oangelo/esp32-gate-intercom/cad/README.md

# CAD

Parametric OpenSCAD for the gate intercom enclosure. Two printed parts plus the hardware that goes
through their walls:

- **base** - the back tray: **closed on the wall face**, which is the one face that carries nothing
  because it beds flat on the post, and opened through its **bottom**, where the two microphone slots
  are cut (ADR-023). It carries the three pads that push the unit forward onto the seat, the two M3
  carriers (ADR-031: gussets grown off the side walls, their insert holes bored into their flat tops),
  the **unit cradles at each end** (ADR-028, ADR-029), the gland's boss and the pad its locknut bears
  on, and — through its own back
  plate — the two M4 pockets and holes that ARE the fixing (ADR-021, ADR-027: no ears on the sides).
- **lid** - the front shell: the **closed grille** over the unit's own grille, the spot-faced seat the
  unit's disc presses on, and the **Ø25.00 flat land** and **Ø22.10 cutout** for the panel button — the
  switch's own 22.00 plus 0.10 of clearance (ADR-018, ADR-033) -- and, since ADR-034, a shell whose convex
  edges are all rolled by 2.00 mm, the front's rim included.

## Files

| File | What it is |
|---|---|
| `case.scad` | The whole enclosure. One file, parameters at the top, `part` selects what to export |
| `media/` | Scratch for renders, written by the `make` targets and git-ignored (empty in a fresh clone) |

Status of `case.scad`: **revision 3, steps 1 and 2 done, re-cut around the assembled unit.** Roadmap
item 5 was decided the other way on 2026-09-24: the Waveshare goes in whole, as it arrives, so the lid
no longer builds its own speaker chamber — its front stays **closed** over the unit's grille and just
drills the sound holes (a O44 recessed field of O2 holes, the unit's own grille right behind them).
Those same holes are the speaker's air path out, and the microphones have their own way in: **two thin
slots, 1.20 × 8.00 mm, through the BOTTOM of the base** close behind the unit, one each side at the
microphones' own x, each under a hydrophobic membrane stuck straight on the bottom's curve (ADR-023,
which moved them off the back plate — that face beds flat against the post — and dropped the Ø9 spot
face that was meant as the membrane's land). Keeping the two apart is the point — the microphones used
to share the speaker's field, which is direct coupling.
The base keeps three pads that push the unit onto a spot-faced seat in the lid. Case depth went from 49
to 58.70 — 58 when the unit went in, 58.4 when the shell grew to 3.4 mm, and the last 0.30 from the
caliper's height — and the unit sits low (centre at 33.4) to free the upper half for the button at 76.4.
`make fit` proves the unit clears both printed parts, that the two parts clear each other across the lap
(`fitcheck_pair`), and — through the probes (`probe_grille`, `probe_button`, `probe_mic`, `probe_gland`,
`probe_m4`, `probe_vent`) — that the openings are open through the walls, by boolean instead of by eye.
`fitcheck_cap` closes the loop on ADR-035's plug: it asks that the cap finds its bore and that its crowned top
never stands on the crown it was cut from.

The lid-to-base joint is cut as of review 3: two M3 x 12 socket head screws (ISO 4762, stainless A2,
into brass inserts per ADR-017) pull the lid down onto two carriers that grow off the cavity's side
walls (ADR-031 — they stood on pillars off the back plate until 2026-10-04), in
the corridor between the unit and the panel switch. Each screw's counterbore is cut from the crown's
own surface at the screw's x, and the lid's boss under it (`m3_lid_boss`) is what the head clamps --
the wall alone is 3.01 mm there and the counterbore is 4.40 (ADR-035: the head sinks **1.40 below the
crown**), so the wall on its own would leave the head with nothing to pull against -- and the boss is what
leaves it the 1.61 it clamps. The 1.40 the head gives up is a **printed cap** (`part="cap"`, Ø5.50, its top cut
by the crown's own cylinder so it closes the hole flush, its bottom stopping on the head). `fitcheck_joint` answers the whole thing by boolean, and
`-D 'fc=...'` narrows the answer when it is not empty -- `screw`, `neighbours`, `cradles` or
`carriers`. `probe_carrier` asks the one question none of those can: that the carriers' material is
where it has to be, by cutting its rods out of the base (they must not exist outside it).

The joint itself is a **half-lap** as of this review (ADR-024): the lid carries a lip and the base the
recess it drops into, all the way round the contour, so the two halves can no longer be shifted sideways
against each other and no longer meet on a bare flat plane. The lip is the outer 1.50 mm of the lid's
3.40 mm shell, reached 3.00 mm back past the plane and **flush** with the case's surface; the recess takes
the outer 1.70 mm of the base's wall over the same 3.00 mm and leaves a 1.70 mm rim, so the two are
**0.20 mm apart** all round. Nothing protrudes any more: the first cut stood the lip 0.40 mm proud as a
**drip shadow**, the user's call was that the ridge reads badly ("fica feio"), and the case grew 0.8 mm
across instead -- its own surface is what a film of water runs down, and the mouth of the 0.20 mm gap is
the first line against it, ahead of the 3.00 mm of lap and the shoulder where the foam ring sits.
`fitcheck_pair` proves the lap by boolean -- the two parts against each other, minus one `eps` either side
of the joint plane, which is a contact and not an interference.
Neither part pays for the lap with support: through its last 3 mm the base's wall goes 3.40 to 1.70 mm and
the lid's 3.40 to 1.50, so both shapes only lose material as the print rises.

The unit is located at **both ends** now, by the four arcs of ADR-028 and ADR-029, and that is where the case's
own width shows: the cavity is Ø60 inside and the unit calipers at Ø57.5, so there is **1.25 mm** of daylight
to spend. The arcs spend 1.00 mm of it on each side and leave 0.25 mm of clearance to the cover at each end.
`-D 'fc="cradles"'` isolates that check. ADR-020's closed collar, which used to hold the back end, is **out**:
its bore was 0.20 mm a side and a 360° ring has nothing to give, so the printed base would not take the unit
at all.

Each band is two arcs of ±35° about the ±X directions, inner surface at r = 29.00. The **front** band runs from
y = 11.05 to 25.55, with a 40° print ramp lifting the clearance past y = 16.05 (ADR-028); the **back** band is
that same profile **translated** to the other end of the unit — hug from y = 48.30 to 53.30, its ramp climbing
away from the mouth and landing on the cavity's floor at y = 55.30, so the first layer the printer lays of it
rests on the plate (ADR-029). Together they are what stops the unit sliding, rattling, and dropping out of the
base when the lid comes off. `fitcheck` proves the clearance, and the arcs are why it stays empty: the surface
that faces the cover is the band's own keep-out cylinder, 0.05 mm inside the sector's chord.

The two wall screws sit on the centre line at the quarter points of the height, z = 24.2 and z = 72.6
(ADR-021), so the pair is symmetric about the case's own centre and the hanging weight arrives at them as
shear. In X they were already on x = 0; only Z moved, from 7/59.

Everything that view draws is switchable, without editing the file: OpenSCAD's **Customizer** panel
(the `show_*` block at the top of `case.scad`) gives a tick box each for the lid, the base, the unit,
the screws, the unit cradles and the M4, plus `show_solid` for the shell drawn opaque instead of as a
background object. All of them default to on, so an untouched file opens exactly as it always did.
Note that the shells are background (`%`) objects and `--render` does not draw those, which is why the
markers show up in the PNGs: in a PNG the shell appears only under `show_solid`.

The print set is **four** parts: base, lid, gasket and, since ADR-035, the two **caps** that close the
counterbores over the screw heads (`part="cap"`, `make cap`, Ø5.50, printed flat, flush when pressed in) --
`make stl` exports all of them.

Still to come: nothing. The feature list is complete as of 2026-09-26. The joint's gasket
is drawn as its own part — `part="gasket"` or `make gasket`: 1.70 mm wide, 1.00 mm of TPU 95A printed soft
and squeezed to 0.70, flat on the shoulder the lap leaves, proved by `fitcheck_gasket` (ADR-024's "The ring
itself"). The vent is a Ø4.20 hole in the middle of the -X side — mid-height, where the capsule's straight
band makes the wall a flat plane and the hole square to it, so the 3.40 mm of wall is crossed cleanly — a
horizontal tunnel with a 4.2 mm bridge for a ceiling, proved by `probe_vent`. It was Ø4.00 with a breathable
membrane **stuck over it** (ADR-026); since ADR-033 it takes a **screwed M5x0.8 e-PTFE breather valve** off the
shelf, and 4.20 is that thread's tapping drill, so the hole is the pilot the valve forms its thread in over
3.05 mm of wall (3.8 turns — the number still to be checked against the part). The mouth still carries the
**Ø11.00 × 0.35 recess** it was given for the patch — 0.50 of clearance around a Ø10.00 patch, and the wall
under the floor goes from 3.40 to 3.05 — and whether that recess becomes the valve's O-ring seat is one of the
open questions, not a decided one. A counterbore in a vertical wall adds no overhang to the print. The two microphone membranes are
drawn too, as patches on the bottom's own curve — `show_mic_mem` — and nothing is cut for them, which is
ADR-023's answer to "the membranes' seats". The gland's top is cut (ADR-025):
a Ø22 x 3.00 boss with a 50 degree tail, a Ø12.50 hole that is a teardrop over its whole length -- its roof
meeting the flat on a 45 degree ramp, which leaves the gasket's washer its 1.20 mm of land without leaving
the print anything to bridge -- and a pad under the locknut. The gland sat on the unit's own axis (29.85 mm
back) so that the pigtail left it and dropped straight into the unit's USB-C, which points up at the unit's
top edge; the user moved it back along +Y twice, 10.59 mm on 2026-09-29 to 40.44 mm (ADR-030), and 3.90 more
on 2026-10-04 to **44.34 mm** (ADR-032), where the boss's tail's point lands exactly on the case's back face
-- the bed -- so the boss's first layer is printed on the plate instead of 3.90 mm above it, and in z from 127.20
to 130.00 the tail merges into the plate as a buttress. The port is still under the hole, so the drop is a
flight of about 22 degrees rather than the plumb line it was, and that is what the two moves cost; the bed's
own plane is the limit now, because further back the point would poke through the plate. For the hole itself
neither move changes anything, which the audit shows rather than asserts. `probe_gland` is what proves that opening is one hole. The two mounting ears were drawn and then dropped, by
the user, the same day: what fixes the case is the two M4 through the back plate, so nothing is added to the
sides and the case stays 66.80 mm wide (ADR-027). The two wall screws are cut, since ADR-021
had them decided: a Ø8.00 x 1.50 pocket in the plate's inner face for the head and a Ø4.50 hole on through
the 3.40 of plate, which leaves 1.90 of it, proved by `probe_m4`.

## Rules for this design

1. **No hardcoded dimensions.** Every number lives in the parameter block at the top, with a comment
   pointing at its source in `docs/dimensions.md`. If a measurement changes, one variable changes.
2. **ASA, not ABS and not PETG.** Outdoors, in the sun, on a gate post (ADR-009).
3. **Wall 3 mm minimum**, 3 perimeters at 0.4 mm. Nothing thinner than 1.2 mm anywhere except a gasket
   groove.
4. **No support material.** No overhang beyond 45 degrees and no bridge longer than 10 mm.
5. **Both parts print lying down**, with the case's depth as the printer's Z: the base on its back plate
   and the lid on its face. That is what makes the lid's grille holes print as vertical holes instead of
   a 44 mm ceiling to bridge, and it depends on the flat lands that step 2 spot-faces into the front
   face.
6. **Clearances are for FDM and for ASA shrinkage**: 0.2 mm for a tight fit, 0.3 mm for sliding,
   0.5 mm for loose. Heat-set inserts instead of printed threads. The board takes M2.5 inserts (its own
   mounting holes are 4.00 mm); the case joint and the ears take M3 and M4.

## Print settings that work for ASA

| Setting | Value |
|---|---|
| Nozzle temperature | 250 to 260 °C |
| Bed temperature | 100 to 110 °C |
| Chamber | enclosed, warm (passively heated by the bed is enough) |
| Part cooling | off, or a very low fan after layer 3 |
| First layer | brim, 10 mm, for warp control |
| Layer height | 0.2 mm |
| Perimeters | 3 |
| Infill | 25 percent, gyroid |

## Commands

    make check     # compile the model and surface any warning or error
    make stl       # export build/case_base.stl and build/case_lid.stl
    make render    # PNG preview into cad/media/ (starts its own Xvfb display)
    make review    # the review view at three angles: screws, carriers, inserts, cradles
    make section   # cutaway render, the review view: the assembled unit inside
    make inside_render  # translucent shell: the unit inside, and the rejected bare-parts layout
    make exploded  # the two printed parts pulled apart
    make fit       # prove the ghosts touch no wall and the openings are open; must be empty twelve times

`make check` must be clean before any export is taken seriously: OpenSCAD happily writes an STL with a
non-manifold object, and a sliced mesh with gaps is a failed print, not a cosmetic problem.

**Renders that show the inside of a shell must pass `--render`, and the shell must be a `%` object.**
Measured on this model: a white shell with `color(..., 0.15)` produced zero pixels of the internal
colours in the PNG, in preview and with `--render`, while the `%` (background) modifier with `--render`
kept all of them. `make inside_render` does both and prints the md5 of the two images, because two
views that must differ and come out byte-identical mean the render path ate the difference, not that
the selector is wrong.

## Validation, not eyeballing

`make fit` answers the interference question with a boolean, not with a picture: it intersects the wall
(the body minus the cavity) with each ghost volume, and an empty result means the part clears every wall.
A non-empty result comes with the ghost's name, and `-D 'fitwhich="speaker"'` narrows it to one part. That
is how the first real error in this file was found: the flat face of the speaker met the curved inner face
of the front, 0.2 mm of interference at the rim, invisible in a render.

Still to come in F2: `tools/check_case.py`, which loads the exported meshes with trimesh and asserts that
each is watertight and a single component, that the board volume fits inside the cavity with the intended
clearance, that no wall intersects the board, the speaker or the battery bay, and that the measured wall
thickness matches the parameter.
