oangelo/esp32-gate-intercom/cad/case.scad

// ESP32 Gate Intercom - enclosure, revision 2
// Parametric case for a Waveshare ESP32-S3-AUDIO-Board. Printed in ASA (ADR-009).
//
// STATUS: revision 2 - the form, the fit and the openings are cut. This file has the capsule profile,
// the crown on the front face, the cavity, the joint at y = 8 with its half-lap (the lid's lip in the
// base's recess), the closed grille field over the unit, the button's lands and its cutout, the two
// microphone slots through the bottom, the two M3 x 12 that close the case, and the unit, speaker and
// buck as ghosts to prove they fit. Still to come, in this order, each one reviewed before the next:
//   1. the gasket itself: the ring is drawn now -- printed in TPU 95A, soft -- and it lies flat on the
//      1.70 mm shoulder the lap leaves. No groove -- at that width a groove would leave 0.35 mm of wall
//      -- and the two screws squeeze the ring from 1.00 to 0.70, which is what the joint closes by
//      (ADR-024 and its 2026-09-26 amendment, ADR-017)
//   2. the list is complete as of 2026-09-26. The cable gland's top went in with ADR-025, the vent is cut
//      in the middle of the -X side with ADR-026, and the microphone membranes need NO seat (they are drawn
//      as patches on the bottom's curve -- ADR-023). The unit is cradled by two bands of arcs on the
//      +/-X sides, one at each end of it (ADR-028, ADR-029): the collar that used to hold its back end
//      is GONE, because on the printed base it was too tight to take the unit at all. There are NO
//      mounting ears: what holds the case is the two M4 through its back plate, which was already cut
//      with ADR-021 (ADR-027 records the reversal)
// Every number below is measured or derived; the source of each is docs/dimensions.md.
//
// Frame: X = width, Y = depth (0 at the apex of the front face, CASE_D at the back plate),
// Z = height (0 at the floor). The case stands upright in use.
//
// PRINT ORIENTATION: both parts print lying down, with the case's Y as the printer's Z.
// The base prints on its back plate (cavity opening up, insert holes vertical, microphone slots
// vertical)
// and the lid prints on its face (cavity opening up, so the grille's 49 holes come out as
// vertical holes instead of a 44 mm ceiling to bridge, and the lands that step 2 spot-faces into the
// crown give it its bed contact). The lap costs neither part a support, and with the lip flush there is
// no sideways step in either part: through its last 3 mm the base's wall goes from 3.40 to 1.70 mm and
// the lid's from 3.40 to 1.50, so both shapes only lose material as the print rises.
//
// One feature has its axis IN the bed, and it is the one that costs: the cable gland goes through the
// TOP, along the case's Z, which is the printer's Y. A boss and a hole lying in the bed plane would need
// support on one side (the print rises along -Y, so everything facing +Y hangs), so the boss carries a
// 45 degree tail on its back side and the hole a teardrop inside -- the same shapes the microphone slots
// get, for the same reason. Rule 4's one concession in the whole case is named where it is made, with
// the gland's parameters.
//
// Usage:
//   openscad -D 'part="base"'         -o build/case_base.stl  cad/case.scad
//   openscad -D 'part="lid"'          -o build/case_lid.stl   cad/case.scad
//   openscad -D 'part="assembly"'     -o cad/media/form.png   cad/case.scad   # opaque, outer form
//   openscad -D 'part="inside"'       -o cad/media/in.png     cad/case.scad   # translucent shell
//   openscad -D 'part="inside_parts"' ...                                     # rejected layout
//   openscad -D 'part="section"'      ...                                     # cutaway, review
//   openscad -D 'part="exploded"'     ...                                     # the two parts apart
//   openscad -D 'part="cradles"'      -o build/cradles.stl cad/case.scad       # the four arcs alone, to measure
//   openscad -D 'part="fitcheck"'     ...                                     # must be EMPTY
//   openscad -D 'part="fitcheck_pair"' ...                                    # must be EMPTY
//   openscad -D 'part="probe_grille"' ...                                     # must be EMPTY
//   openscad -D 'part="probe_button"' ...                                     # must be EMPTY
//   openscad -D 'part="probe_mic"'    ...                                     # must be EMPTY
//   openscad -D 'part="probe_gland"'  ...                                     # must be EMPTY
//   openscad -D 'part="probe_m4"'     ...                                     # must be EMPTY
//   openscad -D 'part="probe_vent"'   ...                                     # must be EMPTY
//   openscad -D 'part="fitcheck_gasket"' ...                                   # must be EMPTY
//   openscad -D 'part="gasket"'       -o build/gasket.stl ...                 # the ring on its own, to print in TPU
//
// Everything is selected through `part`, one selector for every view. The translucent views need
// --render: without it the PNG export draws the shell as opaque and the internals disappear, which
// makes two views that must differ come out byte-identical. Compare with md5 and with
// --summary all, never by looking at the picture.
//
// Convention: millimetres. Variable names are ASCII only (the parser breaks on accents).

// ------------------------------------------------------ the Z stretch (ADR-034)
// The user needs room UNDER the unit: its 2x9 header is the end that points down, and the case gave it
// 1.25 mm. So the unit rises by `lift` and the whole upper assembly rises with it -- the button and its
// two lands, the joint screws and their carriers, the gland, the cavity's ceiling -- which is what keeps
// every clearance the case was checked for exactly as it was (the switch's body stays 0.25 mm off the
// unit's top edge, the land keeps 4.50 of wall above it, the M3 pair stays in the corridor). The only
// new space is below the unit, and that is the point. The capsule pays for it in its straight band.
lift     = 6.00;        // how far the unit rises, and with it everything above it. 6.00 is the user's
                        // "uns milimetros" with a DuPont connector in mind; it is the ONE number to change
// ---------------------------------------------------------------------------------------------------
// THE KNOBS (2026-10-25: "tem um parametro para eu controlar a altura?"). They are independent, they are
// annotated for the CUSTOMIZER (View > Customizer gives each of them a slider or a step), and `make fit`
// is what guards them: a value that pushes a ghost into a wall fails the check instead of printing.
//   case_h -- the height, apex to apex. FLOOR 99.80: the button's land needs 4.50 of wall above it and
//            the cavity's ceiling sits 3.40 below the apex (btn_cz + 12.50 + 4.50 + 3.40). No ceiling,
//            only the print bed (lying on its back the case needs case_h x 66.80 of plate).
//   btn_cz -- the button's centre, from the bottom. FLOOR 79.40: the switch's body (O22, 30 deep) hangs
//            11.00 below the button's centre and has to clear the unit's top edge (68.15) by 0.25. That
//            is what decides how central the button can look: 164.80 was the height that put it at
//            exactly half, and it read too long; at 130.00 the middle is 65.00 and 79.40 is as near as
//            the hardware goes (the button ends up 14.40 above the middle, and 47.20 below the ceiling)
//   m3b_dz -- the two joint screws, this far BELOW the button (they ride with it, so the pair always
//            stays in the corridor between the unit and the switch). 9.40 is the proven number: the
//            carrier's gusset (3.50 either side of the screw) then tops out at 73.50, 0.52 mm under the
//            switch's ghost, which is what fitcheck_joint's `neighbours` bites on -- 8.80 put it 0.08 mm
//            INTO it (btn 79.40, screws 70.60, gusset top 74.10, ghost floor 74.02). At 9.40 the pair
//            straddles the middle of a 150.00 case: 74.70 against 75.00.
/* [The knobs] */
// height of the case, apex to apex. Floor 99.80, no ceiling but the print bed
case_h   = 130.00;      // [100:2:220]
// the button's centre, from the bottom. Floor 79.40 (the switch's body against the unit)
btn_cz   = 79.40;       // [79.4:0.2:160]
// how far below the button the two joint screws sit. 9.40 is the floor for this button height
m3b_dz   = 9.40;        // [8.6:0.2:16]
// NOT moved by the lift, and they have to be checked against it: the microphone slots (cut in the
// bottom, so they stay where the bottom is -- the air path from them to the unit's own ports grows by
// `lift`, which is why 6.00 was preferred to 10) and the two M4, which are the quarter points of the
// height and therefore drift with it (37.50 and 112.50 at case_h = 150.00) -- still symmetric about it.

// --------------------------------------------------------- measured (docs/dimensions.md)
board_dia    = 57.63;   // board is ROUND. The vendor DXF says 58.00, and the unit's own body calipers
                        // at 57.50 (2026-09-26), so the board sits a shade under both. Unused by any
                        // solid: the assembled unit is what goes in now
board_t      = 1.20;    // PCB thickness, vendor STEP (it is not 1.6)
board_hole_d = 4.00;    // three mounting holes, with a 4.80 ring (the vendor's M2.5 studs)
board_hole_r = 23.75;   // radius of the hole pattern from the board centre
board_hole_a = [36.1, -36.1, 180.0];   // hole angles, board frame, +Y pointing down in the case
comp_h_top   = 5.00;    // tallest part on the component side: the 2x9 header
comp_h_bot   = 4.50;    // tallest part on the solder side: the speaker header
mic_port_r   = 26.83;   // microphone acoustic port, from the board centre, component side
mic_port_a   = [47.2, 132.8];
spk_od       = 43.30;   // SPK-4020-5W, no screw holes of its own (used by the bare-parts ghosts,
spk_d        = 20.50;   // which document the hollowing-out option that was rejected)

// --------------------------------------------------------- case parameters
part    = "review";     // the one selector: review | inside | assembly | inside_parts | base | lid |
                        // gasket | section | exploded | cradles | screwplan | fitcheck | fitcheck_parts |
                        // fitcheck_internal | fitcheck_joint | fitcheck_pair | fitcheck_gasket |
                        // probe_grille | probe_button | probe_mic | probe_gland | probe_m4 |
                        // probe_vent
                        // Default is `review`: the shell and the unit as ghosts, the planned screws whole.
                        // `assembly` is the same thing opaque, for the outer form.

// ------------------------------------------------------- what the review view draws
// The switches below belong to the `review` view (and its alias `screwplan2`) -- `part` chooses WHICH
// view, these choose WHAT it draws. They are annotated for the CUSTOMIZER: OpenSCAD's Customizer panel
// (or View > Customizer) shows them as tick boxes, and F5 redraws as you tick. An untouched file draws
// everything, exactly as before.
//
// Why they exist: the review view is the joint seen through the shell, and six solids at once is a lot
// to read. Un-tick what is in the way -- the unit to look at the carrier against the switch, the screws
// to look at the holes they will sit in, both shells to look at the marker set alone.
//
// One trap, measured: the shell is a % (background) object and `--render` does not draw those at all --
// that is exactly why the markers come out visible in the PNGs. So un-ticking the shells changes F5 (the
// preview you work in) and changes nothing in a `make review` PNG; in a PNG the shell only appears with
// `show_solid`, which draws it as an ordinary opaque object instead.
/* [The review view] */
show_lid      = true;   // [true,false]  the front shell, with its grille and the button
show_base     = true;   // [true,false]  the back tray, with the bosses and the carriers
show_solid    = false;  // [true,false]  the shell solid and opaque, instead of a % (background) object
show_unit     = true;   // [true,false]  the assembled Waveshare, as a ghost
show_screws   = true;   // [true,false]  the two M3, their carriers and the brass inserts
show_cradles  = true;   // [true,false]  the arcs that cradle the unit, at both ends of it (cut material,
                        //                drawn green so it reads under the shell)
show_m4       = true;   // [true,false]  the two M4 into the wall, as markers: the pockets and holes they
                        //                sit in are cut in the base (m4_pockets())
show_gland    = true;   // [true,false]  the PG7 gland on the top's boss, with its cable (a marker: the
                        //                hole and the boss are cut into the base, the gland is not)
show_gasket   = true;   // [true,false]  the joint's gasket ring -- printed in TPU -- on the shoulder the
                        //                lap leaves (a separate part: neither half carries it)
show_vent     = true;   // [true,false]  the breathable membrane over the vent hole (a marker: the hole
                        //                through the side wall is cut, the membrane is stuck on)
show_mic_mem  = true;   // [true,false]  the two hydrophobic membranes over the microphone slots (also
                        //                markers: nothing is cut for them, ADR-023)

// DECIDED (2026-09-24): the Waveshare goes in ASSEMBLED, as one cylinder -- board, black body with
// the speaker inside, acrylic band and cover, all screwed together, and its own acoustic chamber and
// microphone ducting come with it. The case is built around that, which is what the depth above and
// the unit placement below are.
//
// The case is closed except for two kinds of opening, both deliberate: the front is solid over the unit
// with a recessed grille field drilled through it (the sound leaves through ours and then through the
// unit's), and the BOTTOM carries the two microphone ports, low and close behind the unit. Neither of
// the other two faces will do for the microphones: the front field is the speaker's own air path (the
// direct coupling ADR-014 exists to prevent) and the wall face is bedded flat on the gate post, so a
// port there breathes mortar, not air. The bottom is what is left, and it is what ADR-014 asked for all
// along ("on the back and low side, facing down where the geometry allows"). The two slots open into
// the 1.80 mm gap behind the unit, which is the volume the microphones breathe.
//
// Height, and why the model uses 47.30: CALIPER, 2026-09-26, on the real part, and the caliper is
// what decides wherever the vendor files disagree (docs/dimensions.md): the whole unit with its
// three rubber feet measures 50.00, the feet are 2.70 stuck on the grille face, and with the unit's
// grille face forward those feet would press against the front wall -- so they come off and the unit
// is 47.30. Diameter, same caliper: 57.50, half a millimetre under the O58 the vendor files claim.
// The vendor sources, for the record: the STEP measures 49.70 assembled (so it reads 0.30 short),
// the product page says 43.70 + 5.10 = 48.80, the DXF says 44.30 to the bottom of the body and
// 47.00 to the bottom of the O52 disc, and 37.60 is PCB top to body bottom. Everything below
// derives from the two calipered numbers, and the whole interior follows them.
unit_dia  = 57.50;
unit_h    = 47.30;      // 50.00 calipered with the feet on, minus their 2.70
unit_face_y = 6.20;     // its grille face: clears the inner crown at the unit's rim by 1.00 mm
unit_cy   = unit_face_y + unit_h / 2;   // 29.85: unit centre on the depth axis
unit_cz   = 33.40 + lift;   // z_btm (33.40) + the lift: was the LOWEST it could sit and still clear the
                        // rounded bottom, and rising is what frees the room below for the 2x9 header's
                        // connectors (ADR-034). Was 33.00 at a 3.0 mm wall: the skin grew 0.4 and the whole
                        // interior came with it, so the 1.25 mm gap around the unit is untouched

case_w  = 66.8;         // the cavity's O60 plus 2 x 3.4 of wall. Was 66.0 at a 3.0 wall: the case grew
                        // 0.8 across so the joint's lip could sit flush with its surface (ADR-024),
                        // which leaves the board 1.19 mm of clearance a side instead of 1.00
straight = case_h - case_w;    // 83.20: the capsule's straight side, z_btm to z_top, from the height above
                        // (it was 30.00 at 96.80, and 98.00 at the 164.80 that read too long)
case_d  = 58.7;         // the unit's depth 47.30 (feet peeled off) + the front gap at its face (6.20)
                        // + the back gap (1.80) + the plate (3.40) = 58.70, so it follows unit_h one
                        // for one. Was 58.0, then 58.4 when the shell grew to 3.4. DECIDED: the
                        // assembled unit goes in whole. Was 49 when the plan was a bare board and our
                        // own chamber
wall    = 3.4;          // was 3.0. The extra 0.4 a side is what lets the lap's lip sit FLUSH with the
                        // case's own surface instead of standing 0.40 proud as a ridge on the outside
                        // (the user's call: "fica feio"). It also takes the base's rim at the lap from
                        // 1.30 to 1.70 mm. The cavity does not move: still O60, 1.25 mm around the
                        // O57.5 unit (ADR-020)
wall_front = 3.0;       // the FRONT wall stays 3.0, so the crown's inner surface, the grille field's
                        // depth and the unit's seat keep the geometry they were designed with. At 3.4
                        // the inner crown would recede to 6.50 at the unit's rim and the seat's own
                        // plane (6.25) would end up inside the wall -- which is exactly how the
                        // fitcheck caught this: 1.30 mm3 of the unit's ghost buried in the lid
r_end   = case_w / 2;   // 33.4: radius of both ends
z_btm   = r_end;                       // 33.4: centre of the bottom semicircle
z_top   = case_h - r_end;              // 63.4: centre of the top semicircle
crown_s = 5.0;                         // sagitta of the front crown (convex front, ADR-015)
crown_r = (pow(r_end, 2) + pow(crown_s, 2)) / (2 * crown_s);   // 114.06

// The joint is `joint_y` (8.0), defined with the lap further down, because that is where its three
// numbers come from. It used to be 27.5 here, as `split_y`: a flat contact, and neither the lip nor
// the screws of review 3 would work there.
inner_d = case_d - wall;               // 55.30: inner face of the back plate
cav_x   = r_end - wall;                // 30: inner radius; the ends share the outside centres
cav_y0  = wall_front;                  // 3.0: inner apex of the crown, at the front wall's thickness
crown_in = crown_r - wall_front;       // 111.06: its radius, so the front wall is 3.0 and not the shell's

// The three board standoffs (r = 23.75 at -36.1, +36.1, 180 degrees) leave exactly three gaps
// against the wall: around 0 degrees (+X side), 108 degrees (upper left) and 252 degrees (lower
// left). Every joint boss, and every feature that has to reach the back plate, lives in one of those three
// gaps, because the board's 57.63 fills the rest of the back plate. Nothing else fits behind it.
//
// With the bottom end round, the cavity narrows fast below z = 33.4 (at z = 8 it is only +-16.0),
// so the board also has to sit high enough that its 57.63 clears the curve: at its centre height
// of 37.4 mm the clearance is 1 mm a side, and it is the sides, not the floor, that decide.

// The inner face of the front is the crown, so it recedes as it goes out: at the speaker's
// radius (21.65) it sits at y = 5.54 instead of 3.40. A flat speaker face has to clear that,
// which is why it starts at 5.65 and why step 1 spot-faces a flat seat into the crown.
spk_cy   = 15.90;       // speaker front face at 5.65, then half its depth (bare-parts ghost)
board_cy = 30.60;       // board front face at 30.00: 4 mm behind the speaker (bare-parts ghost)
board_cz = 37.40;       // board centre height (bare-parts ghost)
spk_cz   = 26.40;       // speaker centre height (bare-parts ghost)

eps = 0.01;
$fa = 2;
$fs = 0.4;

// --------------------------------------------------------- features: grille (lid, lower half)
// The unit brings its own grille behind the disc face, and the case's front is CLOSED over it: a
// recessed field of through holes, so the sound leaves through ours and then through the unit's. The
// microphones no longer share this field: they have their own two ports through the back plate (the
// microphone block further down), which is what stops the speaker from firing straight into them.
grille_od    = 44.0;    // the field, inside the unit's own O46 grille area
grille_rec   = 0.80;    // recess behind the crown's apex: makes the drip lip and a flat print face
grille_hole  = 2.0;     // hole diameter
grille_pitch = 4.5;     // hole pitch; the grid is clipped to a circle of 4 cells
grille_tilt  = 15.0;    // holes tilted so their outer end is lower and water runs out
// The unit is held axially by two things: this flat seat in the lid (the disc's face presses on it)
// and the pads on the back plate pushing it forward. With the front closed over the unit, nothing can
// come forward any more, so the seat's only job is to be flat and to stop the speaker leaking sideways.
unit_seat_d   = 53.0;   // seat diameter: the disc's O52 plus a shoulder
unit_pad_d    = 8.0;
unit_pad_r    = 23.0;   // clear of the vendor's O1 holes (r <= 8.9) and of the O57.5 edge
unit_pad_h    = 1.75;   // the gap behind the unit is 1.80: 0.05 mm of relief so the fit check still
                        // proves the unit clears. In the build a 1 mm foam pad goes here, which also
                        // seals the disc against the seat: that seal is what keeps the speaker out of
                        // the cavity the microphones breathe.

// --------------------------------------------------- the unit's cradles (base, at both ends of it)
// ADR-028 / ADR-029. The pads above hold the unit axially, but nothing touches its sides: the cavity is
// a O60 bore and the unit is a O57.50 body, so 1.25 mm of daylight rings it and it can slide, rattle
// and -- with the lid off -- drop out. Two BANDS of arcs do the locating, one at each end of the unit:
// 35 degrees either side of the +/-X directions, hugging at a quarter of a millimetre. The ring that
// used to hold the back end (the collar, ADR-020) is OUT: its bore was O57.90 against the unit's
// O57.50 -- 0.20 mm a side, a closed 360 degree ring with nothing to give -- and the printed part was
// too tight to take the unit at all (2026-09-28, the user's call). They are arcs and not a full ring
// either (also the user's call): the top and bottom of the bore are left alone.
cradle_a      = 35.0;   // half the arc, measured about the +/-X directions on the unit's axis
cradle_hug    = 5.00;   // the band that hugs at the design clearance, at each end of the unit
cradle_slope  = 0.84;   // rise per mm of depth: 40 degrees, inside the 45 the print rules allow. The cone
                        // that cuts it runs 0.50 mm past each band's end (that overshoot is what keeps
                        // the subtraction off the material's own face), so the slope it ACTUALLY cuts
                        // is 0.798 per mm -- 38.6 degrees. Measured on the mesh (part = "cradles"):
                        // 29.359 at y = 16.50 and 29.758 at 17.00, 0.40 per half millimetre
cradle_clr    = 0.50;   // radial clearance to the unit's cover. Was 0.25, the collar's 0.20 one step up,
                        // and the print proved it too tight at the mouth: the unit has to find the bore
                        // with its rim at an angle, and 0.25 all round is a 0.50 hole on a 57.50 cover
                        // that goes in by hand. 0.50 is A' of the three options put to the user on
                        // 2026-10-24 (A' takes 390.10 mm3 out of the base); it is the widest that
                        // still holds -- 1.00 mm of total play, and each band keeps its full 5.00 mm of
                        // bore at the unit's end (cradle_hug)
cradle_lead   = 1.20;   // the lead-in bevel at each band's mouth (45 deg) -- the front band's faces
                        // the unit's rim, the back band's faces its back end, so what the unit finds is
                        // a mouth and not a step. Was 0.40: with 0.50 of clearance a 0.40 bevel barely
                        // shows, and this is the bevel that does the guiding
cradle_r_in   = unit_dia / 2 + cradle_clr;                  // 29.25: the hugging surface
cradle_r_out  = cradle_r_in + 15;                           // 44: a bound only, body() clips it
cradle_ramp_r = cradle_r_in + 9.5 * cradle_slope;           // 36.98: wider than the bore's own radius
                        // anywhere in the arc (30 / cos 35 = 36.62), which is what makes a ramp fade to
                        // nothing instead of ending on the ledge a printer would have to bridge
// The FRONT band (ADR-028), the one the print proved: its face at the mouth, its ramp leaning away from
// the mouth as the depth grows, and a bevel at that face.
cradle_y0     = 11.05;  // the mouth-side face. NOT nearer the mouth: the joint's band runs to
                        // y = 11.01 (the base's recess, cut over joint_y +/- eps), and a cradle that
                        // reached into it left the recess cut with coincident faces to work on and the
                        // boolean came back with the ring still in place. 0.04 clear of it, and still
                        // the front quarter of a 50.70 deep base.
cradle_y_full = cradle_y0 + cradle_hug;                     // 16.05: where the ramp takes over
cradle_y_end  = cradle_y_full + 9.5;                        // 25.55: past this the front band adds
                        // nothing
// The BACK band (ADR-029), the collar's replacement: the front band's own profile, TRANSLATED to the
// other end of the unit -- not mirrored, and the difference is the print's. The base prints bedded on
// its back plate, so the deep end of the case is the FIRST layer printed (ADR-028 has this the right way
// round: "the cradle's deep end is printed first"). A band whose hug sat at its deep end would begin life
// as a ledge hanging over the void -- 1.00 mm of it at the +/-X directions, and over 6.00 mm at the arc's
// edges, where the cavity's wall is further from the unit's axis -- which is exactly what ADR-028's ramp
// exists to avoid. A first cut here was that mirror (2026-09-28) and the review caught it on sight.
// Translated, the ramp climbs away from the mouth into the deep end and the band lands on the cavity's
// floor, so its own deepest layer is the plate's surface: nothing hangs, and the unit's back end still
// finds a lead-in bevel exactly like the front band's.
rear_y0       = 48.30;  // its mouth-side face, and the first thing the unit's back end meets: 5.20 mm
                        // short of the unit's own back face (53.50), so the 5.00 mm of hug behind it
                        // sits on the unit's last 5 mm -- the skirt the collar gave (3.20) and more
rear_y_full   = rear_y0 + cradle_hug;               // 53.30: where the hug ends and the ramp starts
rear_y_end    = inner_d;                            // 55.30: the cavity's floor. The ramp runs into it
                        // and is cut off there -- 2.00 mm of rise, r = 29.25 to 30.85 at the +/-X
                        // directions, where it fades out entirely at 54.55 -- so the band's deepest
                        // material is the plate's own face. It is also 17 mm clear of the vent's mouth
                        // on the -X side (y = 29.35 +/- 2.00), which `probe_vent` keeps honest anyway

// --------------------------------------------------------- features: button (lid, upper half)
// A bought 22 mm panel switch (ADR-018) seals against a FLAT land, and the front face is convex:
// so the cutout gets a spot-faced land outside (for the switch gasket) and another inside (for the
// nut), which also keeps the wall between them a uniform 3.3 mm.
btn_sw      = 22.0;     // the switch's own cutout (ADR-018): O22 through its thread
btn_clr     = 0.10;     // clearance in the cutout, the user's call (2026-10-24): 0.05 a side. Under rule
                        // 6's 0.2 tight fit, on purpose -- the switch's own gasket is what seals the
                        // hole, so the plastic only has to let the body through without scraping
btn_cut     = btn_sw + btn_clr;   // 22.10: what the lid is actually cut with. The lands below are NOT
                        // keyed to it: they are set by the switch's gasket and nut, so widening the
                        // hole moves neither, and the land's annulus around the hole widens with it
btn_land    = 25.0;     // outer land diameter: the switch gasket's seat, and now the flange's (ABA)
                        // 2026-10-24, the user's call: 25.00, so the flange drops into a pocket whose
                        // FLOOR is flat at y = btn_land_y. Was 29.00, chosen to be flat "gasket and
                        // enough" and not 31 for the ceiling -- with 25 that margin only grows. What
                        // the 4 mm cost: the annulus left around the 22.10 hole goes 3.50 -> 1.45 mm,
                        // still over rule 3's 1.20. Depth of the pocket at its rim (r = 12.50) is
                        // 0.51 mm, not 1.20: the crown is at y = 0.687 there, so that is how far the
                        // floor sits under the surface at the edge. The floor itself is FLAT, which
                        // is what a flange sits on; only the edge depth varies
btn_land_in = 30.0;     // 76 the inner land tops out at 91 and the cavity's ceiling is at 93, so the
                        // wall above the hole keeps 2 mm of material instead of reaching zero
btn_land_y  = 1.20;     // outer land plane: 1.20 mm into the crown at its apex. A round-over at the
                        // pocket's mouth was tried twice on 2026-10-25 and both were rejected: a torus
                        // tangent to the SEAT cut the face at an angle, and the arc tangent to BOTH
                        // needed the pocket 0.50 deeper (1.70) to have room -- and the user still read
                        // it as a step in the wrong place. Dropped: the mouth keeps its 90 degree edge,
                        // and this stays where ADR-033 left it
btn_land_in_y = 4.50;   // inner land plane: uniform 3.3 mm of wall between the two
// btn_cz is a KNOB, set with case_h at the top of the file; see the block there for its floor and why.

// ------------------------------------------------------------------- helpers

module prism_xz(depth, y0 = 0) {
    // Extrude a 2D shape drawn in (x = width, y = height) along the case's Y (depth).
    translate([0, y0 + depth, 0]) rotate([90, 0, 0]) linear_extrude(height = depth) children();
}

module prism_xy(h, z0 = 0) {
    // Extrude a 2D shape drawn in (x = width, y = depth) along the case's Z (height). The gland's boss
    // is this kind of prism: its own axis is the case's Z, so its cross-section is the case's XY.
    translate([0, 0, z0]) linear_extrude(height = h) children();
}

module outline_outer() {
    // A capsule: semicircle at each end, two straight sides, 30 mm of straight between them.
    union() {
        translate([-r_end, z_btm]) square([case_w, z_top - z_btm]);
        translate([0, z_btm]) circle(r = r_end);
        translate([0, z_top]) circle(r = r_end);
    }
}

module outline_inner() {
    // Same shape, offset inwards by the wall: radius r_end - wall = cav_x (30), same end centres.
    outline_offset(wall);
}

module outline_offset(d) {
    // The capsule offset INWARDS by d -- d negative grows it OUTWARDS -- the ends' radius reduced by
    // d with the same end centres. outline_inner() is this at d = wall. The lap uses it twice: at
    // lap_step, for the lip's inner edge, and at -lap_proud, for the lip's outer surface.
    union() {
        translate([d - r_end, z_btm]) square([2 * (r_end - d), z_top - z_btm]);
        translate([0, z_btm]) circle(r = r_end - d);
        translate([0, z_top]) circle(r = r_end - d);
    }
}

// The capsule's own OUTER surface at a given z: r_end out on the straight band (the flat sides), and the
// end circle's radius where an end curves away -- which end by which half of the case the z falls in.
function face_x(z) = (z > z_btm && z < z_top) ? r_end : sqrt(pow(r_end, 2) - pow(z - (z > z_top ? z_top : z_btm), 2));

// The same for the INNER surface (the cavity's wall), cav_x out on the straight band. It exists because
// a carrier's gusset is tall enough to span both regions: before ADR-034 the M3 pair sat above z_top, in
// the top end's circle, and the wall was a sqrt of a positive number; with the case grown, the pair is
// deep inside the straight band, where the old expression took the sqrt of a negative and the gusset came
// out as nan (it cost fitcheck_pair, fitcheck_joint and probe_carrier to catch it).
function cav_face_x(z) = (z > z_btm && z < z_top) ? cav_x : sqrt(pow(cav_x, 2) - pow(z - (z > z_top ? z_top : z_btm), 2));

module crown_outer() { translate([0, crown_r, -1]) cylinder(r = crown_r, h = case_h + 2); }
module crown_inner() { translate([0, crown_r, -1]) cylinder(r = crown_in, h = case_h + 2); }

// ADR-034, option B: the shell is now the OPENING of the two prisms by a ball of radius front_bezel_r --
// erode both prisms by r, dilate by the same ball. Morphologically that rounds EVERY convex edge of the
// shell by exactly r and leaves every flat face exactly where it was, and it does not care which two
// surfaces meet at the crease. That is why it is the only construction that also takes the crease over
// the two DOMES (73 degrees opening to 90 at each apex): a section-based fillet cannot, and three of them
// were built and rejected -- see docs/decisions.md. Set front_bezel_r = 0 to get the old sharp shell.
front_bezel_r = 2.00;
bezel_fn     = 24;      // facets around the dilating ball. The ball has to REACH the original surface, and
                        // a polyhedral ball falls short of its own radius between vertices: at $fn = 10 the
                        // front's apex came out at y = 0.098 instead of 0.00, i.e. exactly r(1 - cos 18).
                        // 24 puts that error at 0.017 mm and costs nothing: the whole base still renders in
                        // 0.2 s, because the core is one convex intersection and Manifold does it fast

module arete_prisms(r) {
    // the two prisms eroded by r: the capsule's outline in by r, the crown's cylinder smaller by r
    intersection() {
        // the prism is also SHORTENED by r at each end: the offset works on the 2D outline only, so
        // without this the prism would still run 0..case_d and the dilating ball would push the case
        // 1.90 mm deeper at the back (measured: the base came out at 60.602 and +14 070 mm3)
        prism_xz(case_d - 2 * r, r) outline_offset(r);
        translate([0, crown_r, -1]) cylinder(r = crown_r - r, h = case_h + 2);
    }
}

module body() {
    if (front_bezel_r <= 0) {
        intersection() {
            prism_xz(case_d) outline_outer();
            crown_outer();
        }
    } else {
        minkowski() {
            arete_prisms(front_bezel_r);
            sphere(r = front_bezel_r, $fn = bezel_fn);
        }
    }
}

module cavity() {
    intersection() {
        prism_xz(inner_d - cav_y0, cav_y0) outline_inner();
        crown_inner();
    }
}

module keep_above(y0) { translate([-500, y0, -500]) cube([1000, 1000, 1000]); }
module keep_below(y0) { translate([-500, y0 - 1000, -500]) cube([1000, 1000, 1000]); }

module sector_xz(r_in, r_out, a0, a1, cz, y0, h, n = 24) {
    // A wedge of an annulus, drawn in the (x, z) plane around (0, cz) and extruded along Y.
    prism_xz(h, y0) translate([0, cz]) polygon(concat(
        [[r_in * cos(a0), r_in * sin(a0)]],
        [for (i = [0:n]) [r_out * cos(a0 + (a1 - a0) * i / n), r_out * sin(a0 + (a1 - a0) * i / n)]],
        [[r_in * cos(a1), r_in * sin(a1)]]));
}

// ------------------------------------------------- the unit's seat and the grille (lid)

module unit_seat_cut() {
    // Spot-faces the inner face of the front flat, so the unit's grille disc has a plane to sit on.
    // 0.05 mm behind the ghost's face: without it the two surfaces are coplanar and the boolean
    // intersection grows slivers instead of reporting a clean empty.
    translate([0, unit_face_y + 0.05, unit_cz]) rotate([-90, 0, 0])
        cylinder(d = unit_seat_d, h = 20);
}

module grille_hole_cut(d) {
    // Same axes for the cut and for the probe, only the diameter changes: 5x5 cells clipped to a
    // circle, tilted so the outer end is lower than the inner one (ADR-018: water runs out). 10 mm
    // of length, because in front of the seat the wall is up to 6.2 mm thick.
    for (ix = [-4:4], iz = [-4:4])
        if (ix * ix + iz * iz <= 16)
            translate([ix * grille_pitch, -1, unit_cz + iz * grille_pitch])
                rotate([-(90 - grille_tilt), 0, 0]) cylinder(d = d, h = 10);
}

module grille_cut() {
    // The field is a spot-face: it gives the drip lip around it and, when the lid prints lying on its
    // face, a flat area instead of one line of contact.
    translate([0, grille_rec - 25, unit_cz]) rotate([-90, 0, 0]) cylinder(d = grille_od, h = 25);
    grille_hole_cut(grille_hole);
}

module unit_pads() {
    // Three pads, 120 degrees apart, pushing the unit's cover forward onto the seat. They are the only
    // thing holding it now: the front is closed over the unit, so it can no longer come out forward.
    for (a = [0:120:240])
        translate([unit_pad_r * cos(a), inner_d - unit_pad_h, unit_cz + unit_pad_r * sin(a)])
            rotate([-90, 0, 0]) cylinder(d = unit_pad_d, h = unit_pad_h + eps);
}

module unit_cradle_y_slab(y0, y1) {
    // A band's own depth band, and the only place any of it is allowed to live: without this the
    // subtraction below would eat into the base's front wall on its way to the bore.
    prism_xz(y1 - y0, y0) square([200, 200], center = true);
}

module unit_cradle_keepout_slab(y0, y1) {
    // The keep-out's own band: 0.05 proud of the cradle's at both ends. The two bands must NOT be
    // coplanar -- exactly coincident faces are how CGAL hands back a zero-thickness sheet instead of a
    // clean subtraction, and here that showed up as the arc's own corners surviving at r = 28.5.
    prism_xz(y1 - y0 + 0.1, y0 - 0.05) square([200, 200], center = true);
}

module unit_cradle_keepout_front() {
    // What the front cradle must NOT occupy: the unit's cover plus `cradle_clr`, and then the print
    // ramp, which is the same surface lifting away as the depth grows. Subtracting it from the case's
    // own solid means the cradle cannot poke out of the shell, and the ramp costs no extra geometry:
    // the steepest face it leaves is `cradle_slope`, 40 degrees, under the 45 the rules allow.
    intersection() {
        union() {
            // the lead-in: 0.40 wider over its own length, so the bevel is 45 degrees at the mouth
            translate([0, cradle_y0 - 1, unit_cz]) rotate([-90, 0, 0])
                cylinder(r = cradle_r_in + cradle_lead, h = 1 + cradle_lead + eps, $fn = 128);
            // the hug itself: the unit's cover plus the clearance, flat along the arc
            translate([0, cradle_y0 + cradle_lead, unit_cz]) rotate([-90, 0, 0])
                cylinder(r = cradle_r_in, h = cradle_hug - cradle_lead + eps, $fn = 128);
            // the ramp: same axis, from the clearance out to `cradle_ramp_r` at the deep end
            translate([0, cradle_y_full, unit_cz]) rotate([-90, 0, 0])
                cylinder(r1 = cradle_r_in, r2 = cradle_ramp_r,
                         h = cradle_y_end - cradle_y_full + 0.5, $fn = 128);
        }
        unit_cradle_keepout_slab(cradle_y0, cradle_y_end);
    }
}

module unit_cradle_keepout_rear() {
    // The back band's keep-out: the front one's three pieces, translated to the other end of the unit.
    // Everything that faces the unit is built the same way -- the lead-in bevel at the mouth, the hug at
    // the clearance, the ramp behind them -- and only the depth band moves, which is what leaves the
    // band's lowest layer sitting on the cavity's floor instead of hanging over the void.
    intersection() {
        union() {
            // the lead-in: 0.40 wider over its own length, so the bevel is 45 degrees at the mouth
            translate([0, rear_y0 - 1, unit_cz]) rotate([-90, 0, 0])
                cylinder(r = cradle_r_in + cradle_lead, h = 1 + cradle_lead + eps, $fn = 128);
            // the hug itself: the unit's cover plus the clearance, flat along the arc. It runs 0.50 past
            // `rear_y_full`, where the ramp takes over, so the two pieces never meet on a coplanar face
            translate([0, rear_y0 + cradle_lead, unit_cz]) rotate([-90, 0, 0])
                cylinder(r = cradle_r_in, h = cradle_hug - cradle_lead + 0.5, $fn = 128);
            // the ramp: same axis, from the clearance out to `cradle_ramp_r`, running past the floor.
            // The band's own slab cuts it off at the floor, so what the print sees is 2.00 mm of rise
            translate([0, rear_y_full, unit_cz]) rotate([-90, 0, 0])
                cylinder(r1 = cradle_r_in, r2 = cradle_ramp_r,
                         h = 9.5 + 0.5, $fn = 128);
        }
        unit_cradle_keepout_slab(rear_y0, rear_y_end + eps);
    }
}

module unit_cradle_band(y0, y1) {
    // One side of one band. Three clips in a row: the case's own solid (so nothing can stand proud of
    // the shell), minus the unit's room and the band's own ramp -- that is `children(0)`, the band's
    // keep-out -- then the arc, then the depth band. The arc's inner radius sits 0.05 clear of the
    // keep-out, so the surface that actually faces the unit is the keep-out's own cylinder and not the
    // wedge's chord.
    intersection() {
        difference() {
            body();
            children(0);
        }
        sector_xz(cradle_r_in + 0.05, cradle_r_out, -cradle_a, cradle_a, unit_cz, -10, case_d + 20, 32);
        unit_cradle_y_slab(y0, y1);
    }
}

module unit_cradles() {
    // Four arcs: both sides, at both ends of the unit. The pair about X is a mirror, the back pair is the
    // front pair TRANSLATED along the depth (not mirrored: see the band's parameters -- the print decides
    // which way round it goes), and together they are the only thing that touches the unit sideways:
    // `fitcheck` proves the 0.25 mm of clearance round the whole cover, and `fitcheck_joint` with
    // `fc = "cradles"` bites the four arcs on their own.
    unit_cradle_band(cradle_y0, cradle_y_end) unit_cradle_keepout_front();
    mirror([1, 0, 0]) unit_cradle_band(cradle_y0, cradle_y_end) unit_cradle_keepout_front();
    unit_cradle_band(rear_y0, rear_y_end + eps) unit_cradle_keepout_rear();
    mirror([1, 0, 0]) unit_cradle_band(rear_y0, rear_y_end + eps) unit_cradle_keepout_rear();
}

// ---------------------------------------------------------- button land and cutout (lid)

module button_cut_hole(d) {
    translate([0, btn_land_y - 8, btn_cz]) rotate([-90, 0, 0])
        cylinder(d = d, h = 8 + (btn_land_in_y - btn_land_y) + 1);
}

module button_lands_cut() {
    // Two flat spot-faces: the switch gasket -- and now the flange -- seals on the outer one, the nut
    // was meant to clamp on the inner one. MEASURED 2026-10-24, and the second half of that sentence
    // is not true of the part: the cavity's front surface is the crown's INNER surface, which runs
    // 3.00 at the centre to 3.99 at r = 15, so material ends between 1.21 and 3.95 and the Ø30 cut at
    // y = 4.50 removes air. The wall the button hole crosses is 2.35 mm at its rim (ray in +Y at
    // x = 11.10: 1.21 -> 3.56), not the 3.30 between the two land planes, and a nut would land on
    // the arch with ~1.0 mm of sagitta over Ø30. Left as it is (the outer land is what seals); the
    // fix, if it is wanted, is a PAD added out to 4.50 in the annulus Ø22.2..Ø30, not a cut.
    translate([0, btn_land_y - 25, btn_cz]) rotate([-90, 0, 0]) cylinder(d = btn_land, h = 25 + eps);
    translate([0, btn_land_in_y, btn_cz]) rotate([-90, 0, 0]) cylinder(d = btn_land_in, h = 25);
}

// ------------------------------------------------- PROPOSED: the joint and the screws (2026-09-25)
// Not cut yet: this block is the plan, and the render view `screwplan` draws it.
// CORRECTED (2026-09-25), on review: no boss on the back plate's outer face. The head seats on the
// plate's inner face, 3 mm off the wall, which is what "rente" means here. The plate is 3.4 mm now (it
// was 3.0), so a O8 counterbore 1.5 mm deep on the inner face plus a low or button head M4 (2.2 mm
// tall) is the combination that works: 1.9 mm of plate left, 0.7 mm of head in the 1.8 mm gap behind
// the unit. A countersunk M4 (2.35 mm) would leave 1.05 mm of plate -- 0.65 when the plate was 3.0 --
// which is still under rule 3's 1.2, so the counterbore stays the way to go. The numbers come
// from working the case's own clearances backwards, and one of them decides the whole layout.
//
// The joint moves to y = 8 (CUT 2026-09-26). At 27.5 it is 27.5 mm behind the front face: a screw
// through the front wall would need M3 x 30 and 17 mm of plastic to cross. At 8 the front part is a
// shallow cap, the screws are M3 x 12 -- the length the BOM already lists and the one the holes below
// are cut for -- and the unit is carried by the deep back part. Everything already modelled survives
// the move: the seat is at 6.25, the grille field spans 3.0 to 6.25, the button's lands sit at 1.2 and
// 4.5 -- all inside 8 -- and the switch's 30 mm body passes through into the back part's cavity, which
// is open air at (0, 76).
//
// The "lábio": a half-lap, in the form the user asked for, with the LID carrying the lip and the BASE
// the recess it drops into, all the way round the joint's contour. The first proposal here had it the
// other way round -- the base's skirt lapping over the lid's rim -- and that does not work at lap_d
// 3.0: the lap's forward end then lands exactly where the crown's own surface reaches the case's full
// 33 mm radius (x = 33 at y = 5.0), so the lid's shell there thins to a feather between the crown and
// the cut. Carrying the lip on the LID puts the whole lap BEHIND the joint plane, in the straight
// sided part of the case, and the crown is never involved.
//
// A true tongue and groove -- a ring standing out of one face into a groove in the other -- does not
// fit this case. The groove needs two walls, 1.2 + 1.4 + 1.2 = 3.8 mm, against the 3.4 mm shell (and the
// 0.4 that the shell did grow went OUTWARD, on the user's call, to make the lip flush -- see ADR-024), and the
// wall cannot be thickened inwards at the joint because the Ø57.5 unit is 1.25 mm from the cavity at that
// height (ADR-020). The half-lap SPENDS the wall instead of adding to it: 1.5 mm of lip and 1.7 mm of
// rim, 0.2 mm of radial clearance between them (rule 6's tight fit), both above rule 3's 1.2 mm.
//
// The lip sits FLUSH: lap_proud is 0.0, and it was 0.40, which stood the lip 0.40 mm proud of the case
// as a ridge on the outside. The user's call, 2026-09-26 ("fica feio"), and the price is paid by the
// wall: 3.0 to 3.4, so the case grew 0.8 mm across (66.8 x 96.8) and the lip's own outer surface IS the
// case's surface. Nothing protrudes and nothing steps -- the parting line is the only thing to see.
//
// What that gives up is the drip shadow the 0.40 was doing: water now runs straight across the parting
// line instead of falling off an overhang 1.90 mm outboard of the mouth of the gap. What is left to stop
// it is the mouth itself -- 0.20 mm, which water enters by capillary action -- and then the whole
// 3.00 mm of lap to climb and the shoulder at the joint plane, where the gasket ring goes (ADR-017). If
// the film at the mouth ever shows up as a problem in use, a 0.40 mm deep rain groove on the parting
// line buys the break back without a ridge; it is not cut because it was not asked for.
//
// The shoulder is 1.70 mm now -- the wall is 3.4 and the recess spends 1.70 -- and still too narrow to
// groove: a 1.00 mm groove would leave 0.35 mm of wall on each side. So the ring lies flat on it and
// the two screws squeeze it. Drawn as of 2026-09-26 (gasket()): 1.70 mm wide, 1.00 mm of TPU 95A
// printed soft (closed-cell silicone foam until 2026-09-26 -- ADR-024's amendment), squeezed 30 percent
// (ADR-017): the joint's closed gap is 0.70, the lid ends up
// that far forward of the printed plane, and the lip reaches 2.30 into the recess instead of 3.00.
joint_y   = 8.0;        // CUT 2026-09-26: was 27.5, and the M3 x 12 screws already cut assume it
lap_d     = 3.0;        // how far the lip reaches back past the joint plane
lap_step  = 1.5;        // the lip's own thickness: the outer 1.5 mm of the lid's 3.4 mm wall
lap_gap   = 0.2;        // radial clearance: the base's rim keeps the inner 1.7 mm and the lip slides on
lap_proud = 0.0;        // FLUSH: the lip does not stand off the case's surface. Was 0.4 -- see above
gasket_y  = joint_y;    // the gasket ring's shoulder, now the face at the joint plane itself: the lap
                        // moved the sealing face off the dome's brim and onto this 1.70 mm annulus
gasket_od = lap_step + lap_gap;   // 1.70: the ring's outer edge IS the rim's outer edge, so what
                                  // separates it from the lip is the lap's own 0.20 mm
gasket_id = wall;       // 3.40: and its inner edge is the case's inner surface
gasket_t  = 1.00;       // free thickness. PRINTED IN TPU 95A (2026-09-26; closed-cell silicone foam
                        // before that -- ADR-024's amendment). Print it soft (2 walls, 10 to 20 % infill,
                        // 2 top/bottom layers) so the two M3 screws can actually take the 30 % below: a
                        // solid TPU ring would need far more force than they can put into printed ASA.
                        // If solid is wanted, drop this to 0.80 and the squeeze becomes 12 percent
gasket_squash = 30;     // percent of it the two screws take out (ADR-017: about 30 percent)
gasket_gap = gasket_t * (1 - gasket_squash / 100);   // 0.70: the joint's CLOSED gap, i.e. how far the
                        // lid ends up forward of the printed joint plane, with the ring squeezed in
                        // between. Nothing bottoms out for it: the 3.00 mm lip reaches 2.30 into the
                        // base's 3.00 mm recess once closed. That is the price of a flat ring -- and
                        // the reason there is no groove, which ADR-024 answers at 1.70 mm.

// The screws, and why they are NOT spread evenly around the loop:
//  - the ring is 3.4 mm thick (wall) and the case is 66.8 wide, so a screw head needs 6.3 mm: there is
//    nowhere in the ring for a countersink, at any angle;
//  - so a screw has to go through the lid's shell (3.4 mm thick, a 1.65 mm countersink leaves 1.75)
//    into material BEHIND it, and that material can only be a boss standing inward from the wall;
//  - a boss standing inward collides with the unit (O57.5 in a O60 cavity: a 1.25 mm annulus) everywhere
//    the unit is widest, which is the whole lower half. The unit's circle is what sets it: a boss
//    needs ~5 mm of width and the room for it only appears at z >= 47 and, cleanly, above z = 62.2;
//  - the back plate cannot take the joint's screws either: it is mortared against the wall.
// So six M3 in the upper two thirds, and the bottom of the loop holds on the mortar and the lap.
screw_m3 = [[27.5, 48], [-27.5, 48], [24, 66], [-24, 66], [13, 88], [-13, 88]];
screw_m3_d = 3.4;       // clearance hole through the lid, self-tapping pilot in the base's boss
screw_m3_sink = 1.65;   // countersunk head, flush with the dome (ISO 10642 / DIN 7991)

// The base to the wall. These go through the back plate from inside, so their heads must stay out
// of the unit's way: the gap behind the unit is 1.80 mm, so each head sits in a 1.5 mm pocket in
// the plate's inner face.
// WHERE (user's call, 2026-09-26): a quarter of the case's height up from the floor and a quarter
// down from the top, on the centre line. In X they were already there -- the old 26 mm radius at 90
// and 270 degrees lands on x = 0 too -- so only Z moved, from 7/59 to 24.2/72.6. Two things improve and
// one gets slightly worse. Better: the pair is now symmetric about the case's own centre (48.4), so
// the hanging weight reaches the screws as shear instead of loading one of them with a moment -- at
// 7 and 59 their centre sat at 33.4, below the mass. Better again: at 24.2 the screw is 9.2 mm off the
// unit's axis, so its head (O8, reaching 13.2) is nowhere near the bore's wall at 30.0 -- which is what
// retired the collar's O9 windows (ADR-020; the collar itself is out now, ADR-029) -- while still
// landing in the 1.8 mm gap behind the unit, and at 72.6 it is clear
// ABOVE the unit (top edge 62.15) and below the switch's body (y = 31.2), so it is reachable with the
// unit already installed. Worse: 48.4 mm between them instead of 52, a little less leverage against
// tipping -- the price of the symmetry, and a small one.
m4_z = [case_h / 4, case_h - case_h / 4];   // 24.2 and 72.6: the quarter points
m4_x = 0.0;                                 // the centre line
screw_m4_d = 4.5;       // clearance for M4 (nylon plug in the masonry)
pocket_m4  = 1.50;      // REVIEW 2: 1.5 mm deep is what the corrected note says: 1.9 mm left

// ------------------------------------------------- REVIEW 3: socket head screws into brass inserts
// (2026-09-25, third review.) Two changes, both from the user's review of review 2, and together they
// replace the rib:
//   - the fastener is a SOCKET HEAD CAP SCREW (ISO 4762 / DIN 912), stainless A2 into a brass insert
//     (ADR-017), not the countersunk one. Its head is CYLINDRICAL, O5.5 x 3.0, so the lid gets a
//     cylindrical counterbore with the head down inside it: nothing stands proud of the case;
//   - the rib becomes a round PILLAR standing off the back plate, carrying the brass insert that the
//     screw bites. No self-tapping into a rib.
//
// Where the pair goes: the unit's circle (O57.5, centre (0, 33.4)) and the switch's body (O22, centre
// (0, 76)) leave a corridor on either side of the centre line. REVIEW 2 put the screw at (17, 68);
// with a O8.2 boss around it on the lid's inner face the gap to the switch's O30 nut flange drops to
// 0.09 mm, which is contact. The pair moves to (18, 67): 1.4 mm to that flange, 3.0 mm to the unit's
// collar as it stood then (out now: ADR-029), 8.9 mm to the cavity's side wall, and what carries the
// insert there (the pillar then, the gusset now, ADR-031) clears the switch's body by 4.2 mm.
m3b        = [18.0, btn_cz - m3b_dz];   // 70.00: m3b_dz below the button, in the corridor between the
                        // unit and the switch's body, so it rides with the button (ADR-034). At 70.00 the
                        // pair straddles the middle of a 150.00 case: 74.70 against 75.00
m3b_d      = 3.40;      // clearance hole for M3 through the lid's boss
m3b_head_d = 5.70;      // counterbore: the DIN 912 M3 head is O5.5 x 3.0, plus 0.05 a side
m3b_head_h = 4.40;      // counterbore depth (2026-10-25, was 3.20): the head sinks 1.40 below the
                        // crown instead of 0.20, and that 1.40 is the cap's thickness. The wall is
                        // only 3.01 here, so the counterbore broke through it even at 3.20: the seat
                        // is the boss below, not the wall. Floor at 5.86, boss material under it 1.61
                        // (rule 3: 1.20). Ceiling on this knob is 4.81 -- beyond that the boss has
                        // nothing left under the head for it to clamp.
m3b_boss_d = 8.20;      // the lid's internal boss: 1.25 mm of wall around the counterbore (rule 3)
m3b_boss_h = 3.00;      // leaves 1.64 mm of material under the head, which is what the head clamps
m3b_shank  = 12.0;      // M3 x 12 socket head, the length the BOM already lists

// THE CAP (2026-10-25, his ask): once the screws are in, the two counterbores are plugged, so the front
// reads as one surface -- "quero fazer uma tampinha, para aparafusar, e depois fechar o buraco".
//
// The cap is a SLICE OF THE CROWN, not a disc with a flat top. Its top face is cut by the case's own
// front cylinder, so it continues the surface to the thousandth: no step to sand, no spot-face to hide,
// nothing to align -- the only witness is the seam of its own O5.50 circle, and that seam sits in the
// same 1.4 degrees of slope the front already has. Its BOTTOM is flat, and flat does two jobs: it is
// what the cap stands on while printing (on the bed, since the lid prints on its face, the cap's bottom
// is already the -Y side), and it is what stops it -- the bottom lands on the socket head's own top
// face, which sits exactly cap_h below the crown, so pressing it in seats it FLUSH instead of letting
// it sink until it disappears. A cap resting on the screw's head is not a compromise: the head is a
// known 3.00 tall and the counterbore's floor is cut from the crown, so both ends of that stack are
// derived from the same two numbers.
m3b_head_k = 3.00;      // the DIN 912 M3 head's own height: the seat is this far below the head's top
cap_h      = m3b_head_h - m3b_head_k;   // 1.40: from the crown down to the face the cap lands on
cap_d      = 5.50;      // O, against the counterbore's 5.70: 0.10 a side, a press fit by hand. In ASA
                        // a printed O5.70 comes out ~5.65, so this is the loose end of "press"; at
                        // 5.58 it needs a mallet. His call if he wants it tighter.
cap_lead   = 0.40;      // 45 degree chamfer on the leading rim, so it starts square in the hole
// The CARRIER (2026-10-04): what holds the insert no longer climbs from the back plate. It grows from
// the cavity's SIDE WALL, in the same family as the four arcs that cradle the unit (ADR-028): a gusset
// keyed into the wall, with the insert's hole bored straight into its flat top. The pillar it replaced
// was a 47 mm column standing free in the cavity, a 47 mm lever with its insert 47 mm from the mouth;
// the carrier is short and its insert is pressed in 10 mm from the mouth.
//
// It is ONE shape: a ramp, a vertical face and a flat top. No cylinder and no cone, and that is the
// point (ADR-031): a boss standing on the gusset would need its own far end closed by a cone so its
// disk did not appear whole in mid-air, and the ramp's top already IS a flat surface the print lays
// down last, normal to the screw. Boring the hole into that surface is the whole of it.
//
// The print sets all three surfaces, and all three are surfaces the cradles already print:
//   - the ramp, at the cradles' own 0.84 mm out per mm of depth (ADR-028), so it starts as a line on
//     the wall and thickens as the print rises: never a ledge, never a bridged face;
//   - the face, VERTICAL (n_y = 0), as the pillar was;
//   - the top, flat and facing -Y: the first surface the print can lay material on over open air.
m3c_ramp   = 0.84;      // mm out from the wall per mm along the depth: the cradles' own ramp
m3c_face_x = 14.0;      // 14.00: the gusset's inner face. The insert's hole is at 18.00 and O4.00, so
                        // its edge is at 16.00 and this leaves 2.00 of material on that side: the same
                        // wall the O8 pillar used to give it, and rule 3's 1.20 with room to spare
m3c_top_y  = joint_y;   // 8.00: the flat top, ON the joint plane -- the surface the insert is pressed
                        // into, and the last thing the print lays down
m3c_ramp_y0 = 15.0;     // where the face ends and the ramp begins. Above it the ramp runs at
                        // x = m3c_face_x + m3c_ramp * (y - m3c_ramp_y0), so at the hole's own x (18.00)
                        // the material reaches 19.76: 1.76 mm behind the hole's floor at 18.00, and
                        // that floor is not sitting on the ramp's own surface
m3c_wall_x = cav_face_x(m3b[1]);   // 30.00: the cavity's side wall at the screw's own z, which with the
                        // case grown to 164.80 is the straight band itself (it was 29.78 when the pair sat
                        // in the top end's circle). The gusset is 3.50 tall either side of the screw, so
                        // it no longer crosses into a curve and the wall it keys into is flat
m3c_key    = 0.75;      // how far past that wall the gusset runs, into the shell's own material:
                        // added material joins cleanly when it is not coplanar with the face it lands on
// The same two faces again, in the SCREW's own frame (m3_carrier is built there, at x = 0 and z = 0 on
// the screw's axis, and m3_carriers puts the pair in). The carrier is not symmetric about that axis --
// the gusset grows outward -- so these are what the mirror below turns into the other side.
m3c_face_xl = m3c_face_x - m3b[0];                  // -4.00
m3c_wall_xl = m3c_wall_x + m3c_key - m3b[0];        // 12.53
m3c_ramp_y = m3c_ramp_y0
             + (m3c_wall_x + m3c_key - m3c_face_x) / m3c_ramp;   // 34.68: where the ramp reaches the
                        // wall. It is the carrier's deepest material, and the first layer it appears in
m3c_z_h    = 3.50;      // half the gusset's height: 63.50 to 70.50. The hole is O4.00, so that is 1.50
                        // of material above and below it, and 1.35 mm clear of the unit's own top edge
                        // at 62.15
m3b_ins_d  = 4.00;      // blind hole for the insert (BOM: M3 heat-set insert, 4.6 OD x 5 long)
m3b_ins_l  = 5.00;
m3b_ins_h  = 10.0;      // hole depth: 5.0 of insert plus 5.0 of relief for the M3 x 12's tip

// The three numbers the counterbore is built from, all read off the crown at the screw's own x. The
// front face is a cylinder, so its surface is a function of x alone and is the same at any z:
m3b_face_y   = crown_r - sqrt(pow(crown_r, 2) - pow(m3b[0], 2));          // 1.46, the crown itself
m3b_wallin_y = crown_r - sqrt(pow(crown_in, 2) - pow(m3b[0], 2));        // 4.47, its inner face
m3b_seat_y   = m3b_face_y + m3b_head_h;                                    // 4.66, the head's seat
// Worked end to end: the shank runs from m3b_seat_y to 16.66, the insert spans 8.00 to 13.00 (all
// 5 mm of it bitten) and the carrier's blind hole ends at 18.00, 1.34 mm clear of the tip.
//
// The collar on the floor (the "lábio") is GONE as of 2026-09-28 -- ADR-020 is superseded by ADR-029.
// It was the ring of rim that located the unit's back end: bore O57.90 against the unit's O57.50 (0.20
// mm a side), 1.25 mm of wall, 5.00 mm tall, its outer 0.20 mm fused into the cavity's wall. A closed
// 360 degree ring has nothing to give, and 0.20 mm is inside what a printed bore can hold, so the unit
// would not go into the printed base at all. The back band of cradles above does its job now: the front
// band's own geometry, translated along the depth, at 0.25 mm.
m4_head_d = 8.0;        // the M4 head, seated in its pocket on the plate's inner face

// --------------------------------------------- features: microphone ports (base, step 3 of the list)
// The two ports, CUT through the BOTTOM of the base, close behind the unit. This is the third face they
// have been on and the first one that survives the mounting. They started on the front, sharing the
// speaker's grille field -- the direct acoustic coupling ADR-014 exists to prevent. ADR-022 moved them
// to the back plate, which is the one face this case cannot use: the plate is bedded flat on the gate
// post (ADR-010, ADR-021), so a port there breathes mortar, and ADR-022 left exactly that open.
// ADR-014 had the answer from the start: "on the back and low side, facing down where the geometry
// allows".
//
// SHAPE: a thin slot, and the printing rules decide that as much as the water does. The base prints
// lying on its back plate, so the case's depth is the printer's Z: a slot whose long axis runs along
// the depth prints as a VERTICAL slit, same cross section from the first layer to the last, with
// nothing to bridge and nothing to support under it. A round hole through the bottom, or a slot lying
// across the width, is a horizontal tunnel in the print whose ceiling is a BRIDGE over the opening --
// 8.00 mm for the slot here and over 40 for one laid across, which rule 4 forbids. Facing down and
// 1.20 wide, the slot also sheds rain and refuses insects, but the seal is the MEMBRANE, not the
// geometry: capillary pressure holds a film in a 1.20 mm slot against only 12 mm of water head, and the
// material is 4.7 mm thick. NO SEAT: the membrane is an adhesive-backed patch and the bottom is a Ø66.8
// cylinder, so a 9 mm patch follows that curve to within 0.31 mm and needs no flat land cut for it. A
// Ø9 x 1 mm spot face was here and is out (2026-09-26, on review); see the note under the parameters.
// The patch itself is drawn now, as a marker on the curve rather than a flat tile (mic_membrane_marker(),
// 5.00 x 12.00 across and along the slot, 0.30 thick): nothing is cut, which is the point of ADR-023.
//
// WHERE: at the microphones' own x (r = 26.83 at 47.2 degrees in the board's frame -- ADR-018's
// measured numbers), one each side, running along the depth and into the gap behind the unit. Each
// slot's last 0.80 mm opens straight into that 1.80 mm gap (the slot ends at 54.30, the unit's back face
// is at 53.50); the rest opens into the 1.25 mm annulus between the unit and the cavity wall, which now
// reaches that same gap outright -- the collar that used to stand between them, and that each slot cut
// a 1.20 mm notch into, is out (ADR-029), so the whole annulus breathes. The two slots
// are 19.2 mm2 of open area against the 6.3 mm2 of the eight Ø1 holes they feed, so the slots are not
// the restriction in the path (ADR-022's reasoning, unchanged).
mic_slot_x   = mic_port_r * cos(mic_port_a[0]);   // 18.23: the microphones' own x, mirrored below
mic_slot_w   = 1.20;    // across the width. 1.20 and not 0.80: below 0.90 the two lines that form the
                        // slot's walls (0.45 each at a 0.4 nozzle) meet in the middle and it prints shut
mic_slot_l   = 8.00;    // along the depth -- the printer's Z, so it prints as a vertical slit
mic_slot_top = 13.0;    // how far the cut reaches up: the cavity's own inner surface at this x is at
                        // 9.56 (radius 30 against the slot's 18.23), so the slot is a through opening in
                        // the wall and not a pocket in it. It used to have to clear the collar's bore as
                        // well and the number stands: 3.7 mm clear of the cradles' arc, whose lowest
                        // point is z = 16.74
mic_slot_cy  = 50.30;   // the slot's centre along the depth: the slot spans 46.30 to 54.30, so its back
                        // end lands 0.80 mm inside the 1.80 mm gap behind the unit (its back face is at
                        // 53.50). The collar this used to cross, spanning 50.30 to 55.30, is out (ADR-029)
mic_mem_w    = 5.00;    // the stick-on patch over each slot: 2 mm of border all round the 1.20 x 8.00,
mic_mem_l    = 12.00;   // so its corners are the only part that has to follow the bottom's curve at all
mic_mem_t    = 0.30;    // membrane plus its adhesive. Drawn as a marker, exactly like the vent's
// DROPPED (2026-09-26, on review): the Ø9 x 1 mm spot face that ADR-022 had as the membrane's land.
// Two reasons. It bought nothing: the membrane is an adhesive-backed patch and the bottom is a Ø66.8
// cylinder, so a 9 mm patch conforms to that curve (0.31 mm of sag) with nothing to peel its edge --
// nothing slides past the bottom of a case on a post. And it went in WRONG on one side: the seat was a
// cylinder along the surface's own normal and mic_points() mirrors the slot on X without mirroring that
// rotation, so the left seat was cut 67 degrees off its normal and left almost no mark -- which is
// exactly how the review found it, a recess on one port and none on the other. What is cut now is a
// plain prism along the depth, which mirrors by construction.
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
