oangelo/esp32-gate-intercom/(commit log)

2026-09-20 chore: initial scaffold
    Repository scaffold for the ESP32-S3 gate intercom: project README, design
    decisions (ADR 001-013), dimension plan, bill of materials, the gate
    installation rules and a parametric OpenSCAD enclosure (v0.0 scaffold,
    dimensions still to be measured). The ESPHome configuration is included with
    credentials removed: API key, OTA password and fallback AP password now come
    from secrets.yaml.
    [case.scad]
2026-09-20 docs(firmware): translate config comments to English
    Comment text only. Verified mechanically: the same 406 lines in both versions
    and zero lines whose non-comment part changed, so the YAML that runs on the
    device is untouched. Portuguese kept where it is an identifier (legacy entity
    names, device names, log strings).
2026-09-20 feat(tools): DXF probe, and the real dimensions from the vendor drawing
    The mechanical drawing was extracted with unar (7z refuses RAR5) and measured
    with a new parser instead of a rendered image: tools/dxf_probe.py reads the
    group-code pairs and reports extents, holes and DIMENSION values.
    Result that changes the design: the board is round, 58.00 mm diameter, with
    three mounting holes (4.00 mm) at 120 degrees on a 23.75 mm radius. An earlier
    rectangular 60 x 40 assumption in the CAD scaffold was wrong and is corrected
    here before any geometry was committed.
2026-09-20 docs(decisions): acoustic layout, front profile, mains outside the case
    ADR-014 speaker forward and microphones at the back and low (physical separation
    buys AEC headroom; coupling measured at roughly 0 dB on 2026-09-19).
    ADR-015 the front face is a capsule: semicircle, straight sides, semicircle.
    ADR-016 the 220 V to 5 V conversion stays outside the printed part; power comes
    in as 5 V through a sealed gland or an IP67 USB-C panel socket.
    ADR-010 amended: the speaker grille no longer has to face down.
2026-09-20 docs: record the moisture strategy and freeze the design conversation
    ADR-017: sealed, vented and coated, with rain and splash as the target.
    docs/roadmap.md: F1 status, F2 design points, and a Where we stopped section
    listing the six open items before F2 can start.
    cad/case.scad: banner marking the v0.0 geometry as superseded (it was built around
    a placeholder rectangular board), plus the measured facts from the vendor DXF.
    [case.scad]
2026-09-25 feat(tools): annotate a render by measured colour
    The review renders carry the internals as coloured volumes, and telling which gold blob is
    which is not something to do by eye in a README. This measures the pixels instead: it counts
    the pixels inside a hue window per view, draws the box around the largest blob and prints
    both, so the label in the picture and the claim in the document come from the same numbers.
    Used as: tools/annotate_render.py <in.png> <out.png> --view unit|section|parts
2026-09-25 feat(case): house the Waveshare assembled, closed front with grille, solid back
    Roadmap item 5 is decided the other way: the Waveshare goes in whole, as it arrives -- board,
    black body with the speaker inside, acrylic band and cover, all screwed into one O58 cylinder
    -- and the case is cut around that. Supersedes the hollowed-out layout, which had been chosen
    to keep our own speaker chamber because the vendor's ducting could not be resolved from the
    STEP. It is resolved now.
    - depth 49 -> 58 mm; the unit's grille face sits on a spot-faced seat in the lid (6.20 behind
    the crown at the disc's rim), held axially by three pads on the back plate
    - the unit sits low (centre at z = 33, the lowes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
    [case.scad]
2026-09-25 docs: record the decisions the case design produced
    ADR-018: a bought O22 mm panel switch in the front face, on a flat land, instead of a printed
    button; plus the panel-socket and gland options for the 5 V entry.
    docs/decisions.md also carries the ADRs that came out of the dimensions and acoustic
    conversation (the caliper rule, where the sources disagree).
    hardware/bom.md: the case-side items those decisions need.
2026-09-25 feat(firmware): migrate the intercom to the VoIP stack
    Replaces the intercom_api component with voip_stack and the audio_dac/audio_adc pair with
    esp_audio_stack, adding media_source and media_player; the ESP32-S3-AUDIO-Board is now the
    SIP endpoint and Home Assistant calls it as a phone.
    interfone-portao.intercom-api.yaml keeps the previous software stack as it stood, for the OTA
    rollback path. firmware/esphome/.gitignore stops the ESPHome build dir and secrets.yaml from
    ever being staged in the subdirectory.
    [interfone-portao.intercom-api.yaml, interfone-portao.yaml]
2026-09-25 feat(case): propose the joint lap and the two screw sets, translucent by default
    The default view is `inside` again, so the model opens with the shell
    semi-transparent and the unit visible inside it. That is what was asked
    for and it costs nothing.
    New `screwplan` view and `make screwplan` draw the proposal as rods: six
    M3 through the lid into the base, three M4 from the back plate into the
    wall. Nothing is cut into the geometry yet, the proposal lives in the
    PROPOSED block of case.scad and is up for review.
    Why the screws cannot go all round the loop, measured rather than
    guessed:
    - The unit is O58 in a O60 cavity, so the annulus is 1 mm per side.
    There is no room for a boss, a head or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
    [case.scad]
2026-09-25 docs(case): the wall screws seat on the plate, 3 mm off the wall
    On review: no boss on the outer face. The plate is 3 mm, so the head
    seats on the inner face and lands 3 mm off the wall, which is what was
    asked for. A O8 counterbore 1.5 mm deep plus a low head M4 (2.2 mm) puts
    0.7 mm of head in the 1.8 mm gap behind the unit. A countersunk M4 needs
    2.35 mm and would leave 0.65 mm of plate, so it is out.
    [case.scad]
2026-09-25 feat(case): review 2, two joint screws and the unit's collar
    On review the joint takes two M3, not six: they go in the corridor between the unit (O58 at (0, 33)) and the button's switch body (O22 at (0, 76)), mirrored at (+-17, 68). Measured there: the unit is 9.91 mm clear, the switch body 7.79 mm, its nut flange 3.79 mm, and the case's outline is +-32.6, so a O6.3 countersink (its edge at 20.15) fits with room. The boss cannot stand off the wall (the cavity's wall is 12.6 mm out at z = 68), so it is a rib that runs from the screw's axis to the side wall. M3 x 16: 13 mm from the joint plane to the rib's tip, 12 mm of thread.
    The unit's back gets a collar on the floor: bore O58.4, so 0.2 mm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
    [case.scad]
2026-09-25 feat(case): draw the plan whole, and open the file on it
    Opening case.scad now shows where the screws go. Two bugs kept it hidden: part = "inside" was assigned at the top, so the dispatch never reached the branch that draws the markers; and the review view cut the case in half, which was unreadable.
    review_view(): the shell as a % background object, the unit as the ordinary ghost, then the two M3, their ribs, the collar and the three M4 drawn opaque, all visible through the shell. --render carries a single background object: with the unit also as a %, it vanished from the frame (0.0 percent, measured), so it is opaque now and the collar rim reads around it as a ring.
    The two M3 are screws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
    [case.scad]
2026-09-25 feat(case): two wall screws on the vertical axis, and the supply settles as single stage
    The three M4 into the masonry become two, at 90 and 270 degrees on the 26 mm radius, both on the vertical axis. The case hangs, so its weight arrives at the screws as shear and not as a moment, and the flat contact with the wall plus the mortar takes the rest. They stay behind the O58 footprint of the unit and clear of the standoffs at 0/120/240.
    The older screwplan view drew the six-M3 layout that was dropped; its rods follow the same plan now, two M3 and two M4, and the annotations say what they draw. Stale number fixed: the M4 pocket is 1.5 mm, not 1.7.
    ADR-016 confirmed 2026-09-25: 5 V is fed in di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
    [case.scad]
2026-09-25 feat(case): cut the joint - socket heads into inserts on pillars
    The rib and the countersunk head are gone. The lid is now held by two M3 x 12
    socket head screws (ISO 4762) into brass inserts, and the geometry is cut, not
    drawn: `fitcheck_joint` proves it by boolean.
    - the fastener is a socket head, so the lid gets a cylindrical counterbore cut
    from the crown's own surface at the screw's x (the front is a cylinder, so a
    pocket measured from a plane would tip the head) and its head ends up inside;
    - the wall under the crown is 3.04 mm and the counterbore 3.20, so the lid
    carries a boss exactly there: that boss is what the head clamps;
    - the rib becomes a pillar off the back plate to th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
    [case.scad]
2026-09-25 feat(case): switch the review view's parts on and off from the Customizer
    Six solids at once is a lot to read when the question is one of them, so the
    review view's parts are now individually switchable, without editing the file:
    the switches are Customizer-annotated, i.e. tick boxes in OpenSCAD's Customizer
    panel, and F5 redraws as you tick.
    show_lid, show_base, show_unit, show_screws, show_collar, show_m4, show_solid
    All default to on (show_solid off), so an untouched file opens exactly as before
    -- the three review PNGs come out byte-identical. The collar moves out of
    screw_markers2 into its own switch, and `show_solid` draws the shell opaque for
    looking at the outer form.
    Measured,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
    [case.scad]
2026-09-26 feat(case): cut the collar - 1 mm of wall, 5 mm tall
    The collar was a drawing; it is printed material now, and the numbers come
    from the cavity's own width: cav_x = 30.0 inside and a O58 unit means the gap
    between them is exactly 1.0 mm, so the old O63 collar (2.3 mm of wall) had
    nowhere to go -- it would have cut into the wall. It spends the millimetre:
    1.0 mm of wall on 0.2 mm of clearance, so its outer O60.4 sits 0.2 mm inside
    the cavity's wall and fuses with it, which is what backs a 1.0 mm ring (rule 3
    asks for 1.2).
    Height goes from 1.75 to 5.00: 1.80 of it is the gap behind the unit and 3.20
    is skirt over the unit's body, which cuts the unit's free cocking from
    atan(0.4/1.75) = 12.9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
    [case.scad]
2026-09-26 feat(case): move the two wall screws to the quarter points of the height
    The two M4 into the masonry go from z = 7 and 59 (the 26 mm radius around
    the unit's axis, at 90 and 270 degrees) to z = 24 and 72: a quarter of the
    case's height up from the floor and a quarter down from the top, on the
    centre line. In X nothing moved -- that old radius already landed on x = 0 --
    so only Z changed, and it is now expressed as case_h / 4 instead of a radius.
    Why it is better: the pair is centred on the case's own centre (48), so the
    hanging weight arrives at the screws as shear instead of loading one of them
    with a moment. 7/59 had the same argument written next to it and only half kept
    it, with its mid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
    [case.scad]
2026-09-26 feat(case): cut the two microphone ports through the back plate
    Two O4 mm holes through the back plate, low and behind the microphones, each
    with a O9 x 1 mm spot face on the outside as the seat for its hydrophobic
    membrane. They land at r = 26.83 at +-47.2 / 132.8 degrees in the BOARD's own
    frame -- the measured port positions -- which in the case is z = 17.3, one
    either side of x = 0, because the board's +Y points down here (ghost_board).
    Why cut them at all: the case was closed except for the front grille, so the
    microphones' only air path was the same O44 field the speaker fires through.
    That is direct speaker-to-microphone coupling, which is the one thing ADR-014
    exists to prevent -- t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
    [case.scad]
2026-09-26 feat(case): cut the microphone ports through the bottom, as thin slots
    The back plate is the one face this case cannot open: it beds flat on the gate
    post, so a port there breathes mortar, not air, and the microphones fall back to
    listening through the speaker's grille -- the coupling ADR-014 exists to prevent.
    ADR-022 had already flagged it as open. ADR-014 asked for the bottom from the
    start: "on the back and low side, facing down where the geometry allows".
    Two slots, 1.20 x 8.00 mm, one each side at the microphones' own x (+-18.23),
    running 46.00 to 54.00 along the depth and cut up past the collar's bore, so the
    opening goes through the shell AND the collar and its back 0.80 mm lands in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
    [case.scad]
2026-09-26 fix(case): drop the Ø9 spot face on the microphone slots
    The seat was the membrane's flat land, carried over from ADR-022 without
    asking whether the bottom needed one -- and it bought nothing: the membrane is an
    adhesive-backed patch and the bottom is a Ø66 cylinder, so a 9 mm patch follows
    that curve to within 0.31 mm, and there is nothing at the bottom of a case on a
    post to peel its edge, which was the other half of ADR-022's reason for it.
    Worse, it went in wrong on one side, which is how the review caught it as a recess
    on one port and none on the other. mic_face_cut built the seat as a cylinder along
    the surface's own normal at the slot's x, and mic_points mirrors the slot on X
    with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
    [case.scad]
2026-09-26 feat(case): cut the joint as a half-lap, with the lid's lip standing 0.40 mm proud
    The two halves no longer meet on a bare flat plane. The lid carries a lip -- the
    outer lap_step (1.50 mm) of its 3.00 mm wall, carried lap_d (3.00 mm) back past the
    joint plane -- and the base carries the matching recess, the outer 1.70 mm of its
    wall removed over the same 3.00 mm, which leaves it a 1.30 mm rim. The two are
    0.20 mm apart all the way round the contour, so the parts can no longer be shifted
    sideways against each other by hand.
    The lip stands lap_proud (0.40 mm) clear of the case's own surface: its back edge
    overhangs the base, so water running down the case leaves the lid at that edge and
    lands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
    [case.scad]
2026-09-26 feat(case): thicken the shell to 3.4 so the lap's lip sits flush
    The 0.40 mm the lip stood proud was the lap's drip shadow, and on the outside it
    reads as a ridge in the middle of the case's flank. The user's call: no ridge, and
    the lip stays. So the wall pays for it -- 3.0 to 3.4 -- and the lip's own outer
    surface IS the case's surface. Nothing protrudes and nothing steps; the parting
    line is the only thing to see there.
    - case 66.8 x 96.8 x 58.4, uniformly (case_d 58.4 holds the back plate's inner
    face at 55.00, so every depth behind the unit is unchanged)
    - the cavity does not move: O60, 1.00 mm around the O58 unit. The whole interior
    came out 0.4 with the skin (unit_cz = z_btm), so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
    [case.scad]
2026-09-26 docs(case): bring the M4 block and ADR-021 up to the 3.4 shell
    The shell's growth moved the quarter points of the height from 24/72 to
    24.2/72.6 and left the back plate at 3.4, so the M4 note's own arithmetic
    changes with it: 1.5 mm of plate left becomes 1.9, and a countersunk M4 (2.35
    tall) would now leave 1.05 instead of 0.65 -- still under rule 3's 1.2, so the
    O8 x 1.5 counterbore on the inner face stays the way to go.
    The M4 holes themselves are still markers, not cuts: show_m4 draws the two
    screws as ghosts and the block says so. No geometry in this commit.
    make check: clean.
    [case.scad]
2026-09-26 docs(case): repair the header's print-orientation sentence
    The 3.4-shell edit left a dangling clause in the file header. It now says what
    rule 5 says: printing the lid on its face is what turns the grille's 49 holes
    into vertical holes instead of a 44 mm ceiling to bridge. Comments only.
    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
    [case.scad]
2026-09-26 fix(case): take the caliper's numbers, O57.5 x 47.30, and let the depth follow
    The user calipered the assembled unit: **50.00 with its three rubber feet on**
    (so 47.30 with them peeled off, which is 0.30 more than the 49.70 the STEP
    says) and **57.50 across the body** (0.50 under the DXF's O58.00 circle, 0.13
    under the STEP's board). The caliper wins wherever the vendor files disagree --
    that is the rule docs/dimensions.md states -- so both numbers go into the model
    and the depth chain follows them, one for one:
    case_d 58.40 -> 58.70 (6.20 face + 47.30 + 1.80 gap + 3.40 plate)
    inner_d 55.00 -> 55.30 which carries the collar, the M4 pockets, the
    s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
    [case.scad]
2026-09-26 feat(case): cut the gland's top -- boss, hole and locknut pad (ADR-025)
    The 5 V entry, and the cable route with it: a PG7 through the top of the case on
    the unit's own axis, x = 0, y = 29.85 (= unit_cy). The unit's own USB-C is at its
    top edge pointing up (z = 58.30, top edge 62.15), so the gland sits directly above
    it and the pigtail drops into the port without a bend. Nothing else had to move:
    the free space above the unit is where that route already lived.
    What is cut, all three in the base:
    - gland_boss(): O22, 3.00 mm proud of the top's apex (the flat lands at 99.80),
    its root buried at z = 94 where the shell's own surface is still 12.93 wide, so
    its sides emerge from the ca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
    [case.scad]
2026-09-26 feat(case): cut the wall screws' pockets and holes (ADR-021's amendment)
    The two M4 into the masonry went in last: they were the only item left in
    `cad/README.md`'s "still to come" with a decision already behind it (ADR-021 put
    them on the centre line a quarter up and a quarter down, at z = 24.2 and 72.6),
    so they were drawn as markers and never cut. They are cut now.
    m4_pockets(), taken from the plate's INNER face (y = inner_d = 55.30, which is
    flat, so this one needs no teardrop and no spot-face -- unlike the gland's
    locknut, whose ceiling arches):
    - a O8.00 pocket 1.50 deep for the head: the gap behind the unit is 1.80 mm and
    the head stands 2.20, so it seats in the plate and only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
    [case.scad]
2026-09-26 feat(case): draw the joint's gasket, flat on the lap's shoulder (ADR-024)
    The first of the four items left in cad/README.md, and the only one with nothing
    left to decide: ADR-024 settled that the foam ring lies flat on the 1.70 mm
    shoulder the lap leaves and that there is no groove (at that width a 1.00 mm
    groove would leave 0.35 mm of wall each side), and ADR-017 settled the foam and
    its compression.
    gasket() is that ring, as its OWN part -- it belongs to neither half, which is
    why nothing is unioned into base() or lid() and why its own printability is not a
    question: it is cut from a sheet or bought as a ring.
    - 1.70 mm wide: its outer edge IS the rim's own outer edge (lap_step + lap_g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
    [case.scad]
2026-09-26 feat(case): cut the vent, high on the -X side (ADR-026)
    Item 2 of the four left: the breathable membrane that equalises pressure.
    ADR-017 already decided the case is vented and why -- outdoors the failure mode
    is thermal pumping, not the rain that lands on the box -- so this only fixes
    where, and the position is the design's, not a preference (the user asked for the
    one I think is best).
    - a side, not the back: the back plate beds flat on the post (ADR-021);
    - high up (z = 78): it breathes the case's warmest air, and it is as far as the
    design gets from the two microphone ports, which are on the bottom -- the
    microphones once shared the speaker's field and that was direct coupli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
    [case.scad]
2026-09-26 feat(case): draw the microphone membranes, and close the seat question
    Item 3 of the four, and the honest answer to it is that there is nothing to cut:
    "the microphone membranes' seats" asks for a seat, and ADR-023 already answered
    that there is none -- the membrane is an adhesive-backed patch, the bottom is a
    Ø66.8 cylinder, and a 9 mm patch follows that curve to within 0.31 mm, which is
    why the Ø9 x 1 mm spot face ADR-022 carried is out. What was missing was the
    patch itself, so this draws it.
    mic_membrane_marker() puts the two membranes in the review view as a 5.00 x 12.00
    patch, 0.30 thick -- 2 mm of border all round the 1.20 x 8.00 slot -- and it is
    the SHAPE of the marker that carri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
    [case.scad]
2026-09-26 fix(case): move the vent to the middle of the side, where the wall is flat
    The vent went in at z = 78 -- high up on the -X side, near the top end's
    curvature. The user's call, same day: the middle of the side. It is also the
    better cut, and for a geometric reason rather than a visual one.
    The case's outline is a capsule: a 66.80 wide rectangle from z = 33.40 to 63.40
    with a semicircle at each end. So on that straight band the outer surface is a
    FLAT PLANE at +-33.40 and the cavity's wall the same plane at +-30.00, and a hole
    drilled into it along X is square to the surface at both ends across a uniform
    3.40 of wall. At z = 78 the surface was the top end circle: the mouth was cut on
    a slope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
    [case.scad]
2026-09-26 feat(case): cut the mounting ears, low on the sides (ADR-027)
    Item 4 of the four, and the last one on the feature list: "mounting tabs
    for a wall or a pole" (F2). The two M4 through the back plate want masonry
    or a wooden post behind them; the ears are for everything else.
    Two lugs, one per side, low at z = 14.00, each a prism along the case's
    depth from y = 42.00 to 54.00 whose cross-section is the hull of two O9.00
    hubs -- one buried in the case's wall, one carrying the eye -- with a O5.00
    eye through it along the case's Y. That is an M4 (rule 6's 0.3 sliding) or
    a narrow cable tie. Rule 3 holds on both sides of the eye: 1.20 mm of
    material inside it, 2.00 at the lug's tip.
    WHERE: the si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
    [case.scad]
2026-09-26 revert(case): drop the mounting ears - the back plate's two screws are the fixing
    The user's call, the same day the ears were drawn: "nao quero orelhas de
    fixacao, quero fixar com parafusos no fundo". The ears came out, and the
    fixing is the two M4 through the back plate that ADR-021 had already cut.
    Removed: the parameter block, ear_profile(), mounting_ears(), ear_holes(),
    ear_probe(), their call in base() and in its cut list, the probe_ear branch
    of the part dispatcher, its line in the usage list, its name in the part
    selector, and probe_ear from the make fit loop. ADR-027 is rewritten as the
    reversal rather than deleted: it keeps what the ears were (the strap/pole
    alternative to those sc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
    [case.scad]
2026-09-26 fix(case): the PG7's hole never reached the top - the collar was cut upward
    The round collar of the gland's hole was cut with
    translate([0, gland_cy, gland_flat_z + 1]) cylinder(d = gland_d, h = gland_round + 1);
    and cylinder() grows toward +Z from its own origin, so the collar went UP, outside
    the case: the hole stopped at z = 98.60 and the 1.20 mm above it -- the flat the
    gland's washer seals on -- stayed solid. The user found it looking at the part
    ("a parte de cima do cilindro esta fechada"), after three answers had said the hole
    was there.
    probe_gland had the same mistake in its own collar piece, which is why it kept
    reporting empty against a closed part: its pieces ran 100.80 up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
    [case.scad]
2026-09-26 docs(adr-015): close the two open items - neither needed the caliper
    ADR-015 left "the radius and the height of the straight section" as open items to be fixed
    with the caliper numbers and a photograph of the board. Both are settled, and both came out
    of the model rather than the bench:
    - the straight section is 30.00 (case_h = 30.0 + case_w);
    - the crown's radius is 114.06, derived in case.scad as
    (r_end^2 + crown_s^2) / (2 * crown_s) with r_end = case_w / 2 = 33.40 and crown_s = 5.00,
    so the case's width and its crown follow from the board's body diameter alone. That
    diameter came in at 57.50 by caliper, against the DXF's 58.00 and the STEP's 57.63 x 56.54,
    both of which run high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
2026-09-26 fix(case): the vent's membrane marker floated 0.30 mm off the wall
    vent_marker() translated the patch to vent_face_x + vent_mem_t and the cylinder then grew
    outward from there, so the disc it draws spanned 0.30 to 0.60 outside the wall instead of
    sitting on it -- 0.30 mm of air under a patch that is supposed to be stuck to the surface.
    Same +axis placement slip as the gland's collar (ADR-025's amendment): a cylinder placed by
    its own +Z end where the geometry calls for its inner face.
    It is now placed by that inner face: the disc spans |x| = vent_face_x (33.40, the wall's
    outer surface, the 3.40 mm of material the vent check measures) outward by its own 0.30
    thickness. Review-only marker, s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
    [case.scad]
2026-09-26 feat(case): recess the vent's mouth, O11.00 x 0.35, so the patch finishes flush
    The stick-on membrane sat on the panel's surface. It now drops into a counterbore cut into the
    vent's mouth: O11.00 across, 0.35 deep -- the patch's own thickness -- so a O10.00 patch lands
    on a floor and its top face ends level with the wall. The patch's edge is then inside the rim,
    where nothing can lift it from the side, and the panel's surface stays smooth.
    The wall under the floor goes from 3.40 to 3.05 (rule 3's floor is 1.20). The print does not
    change: a counterbore in a vertical wall is a different 2D cross-section per layer, so no new
    overhang and no new bridge; the only bridge in this opening is still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
    [case.scad]
2026-09-26 docs(bom): catch the bill of materials up with the case as drawn
    The BOM had drifted from what the CAD now implements. What changed:
    - the vent's membrane was missing entirely: ePTFE, IP67/68, O10.00 x 0.30-0.35,
    hydrophobic AND oleophobic, dropping into the O11.00 x 0.35 recess the mouth now
    carries (ADR-026). Oleophobic is called out because its absence is the silent failure
    mode -- oil mist closes the pores and the case quietly stops breathing.
    - the gasket was "silicone cord 2 mm, or a matching O-ring, sits in the lid groove".
    There is no groove and no cord: ADR-024's joint is a half-lap whose shoulder takes a
    1.00 mm closed-cell silicone foam ring, 1.70 wide, and `make gasket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
2026-09-26 docs: the joint's gasket is printed in TPU, and the BOM gets its links
    Three changes, all of them the same decision working through the tree.
    1. ADR-024's gasket is TPU now, the user's call (2026-09-26). A printed ring springs back
    instead of taking a set, and TPU is already on the shelf, so the closed-cell silicone
    foam it replaces never gets bought. Same geometry: 1.70 wide, 1.00 thick, squeezed to
    0.70 when the two screws are home. The print has to be SOFT -- 2 walls, 10 to 20 %
    infill, 2 top/bottom layers so the seal faces come out solid -- because the 30 %
    squeeze is the design's own number (ADR-017) and a solid TPU ring would need far more
    force to reach it than two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
    [case.scad]
2026-09-27 feat(case): cradle the unit's front end with two arcs (ADR-028)
    The bore is O60 and the unit's cover is O57.50, so 1.25 mm of daylight rings it: the unit could
    slide and rattle against the shell, and with the lid off nothing held it in the base at all. The
    three pads on the back plate only push it forward, onto the seat in the lid; the collar locates its
    back end. Its front end was located by nothing.
    Two arcs now, one on each side along the +/-X directions, the user's call: 35 degrees either way,
    from y = 11.05 to 25.55, standing 0.25 mm off the cover -- the collar's 0.20, one step up. Together
    the two ends locate the unit, so it no longer drops out when the case is opened, which is the po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
    [case.scad]
2026-09-28 fix(case): the back band is the front band translated, not mirrored
    The base prints bedded on its back plate, so the case's deep end is the
    first layer printed. A hug at the deep end therefore begins life as a
    ledge hanging over the void -- 1.00 mm of it at the +/-X directions and
    over 6.00 mm at the arc's edges, where the cavity's wall is a plane and
    sits further from the unit's axis the further the arc turns from +/-X.
    That is the one thing ADR-028's ramp exists to avoid, and the first cut
    of this band had it on the wrong end: the profile was mirrored in the
    depth. The review caught it; every boolean had been happy with it.
    The band now runs the front band's own profile translated to the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
    [case.scad]
2026-09-28 feat(case): the gland's teardrop runs the whole hole, capped where the washer lands
    ADR-025's second bullet left the last 1.20 mm of the hole round: that is the band
    the gland's O16 washer seals on, and a full teardrop's tip (r / cos 45 = 8.84) comes
    out 0.84 mm past the washer, which is a leak path. The price was the hole's only
    bend of rule 4: over that band the roof stayed a round ceiling, and the printer had
    to bridge it on its own -- the one place in the hole where the tent was not doing
    its job. The user called it on the print.
    The teardrop now runs into the band as well, with its tip capped at 6.80 mm from the
    hole's axis: the flanks keep their 45 degrees, the roof finishes on a 4.08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
    [case.scad]
2026-09-29 fix(make): check stops reporting its own status line as an error
    OpenSCAD's log ends with 'Status: NoError', and the check's grep for
    warning|error matched it, so 'clean compile' could never be printed
    and every run looked dirty.
2026-09-29 fix(case): the gland's roof meets the flat on a ramp, not a flat cap
    The cap closed the mouth band's roof with 4.08 mm of ceiling, and a
    ceiling is a bridge wherever it stands: the printer has to cross the
    void in one layer. The user read it off the printed part, and asked
    whether the hole could be moved so that the teardrop's beginning
    landed on the print plate. It cannot: the plate is the back plate's
    own outer face (y 58.70) and the tent's beginning sits r*cos45 = 4.42
    above the hole's axis (y 25.43), so that would need the axis at 63.12,
    4.42 mm behind the back plate -- and at the deepest position the
    geometry allows the beginning is still 14.07 mm off the plate.
    Support is a question o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
    [case.scad]
2026-09-29 fix(case): the gland moves 10.59 mm back along +Y (ADR-030)
    The user's call, asked twice: put the teardrop's beginning as low in the
    print as this part allows. The hole's axis leaves the unit's own axis and
    goes from y = 29.85 to 40.44. It stops there because of the boss's own
    tail, not the hole: the tail is 14.36 mm from the axis, so 40.44 puts its
    end at 54.80, clearing the cavity's floor by 0.50 -- the clearance the
    cradles keep. The bore alone could reach 49.05, where it grazes the
    plate's inner face, but the tail would then be through the plate and out
    of the case's back at 63.41.
    The print does not notice, and that is measured rather than argued. The
    roof over the axis reads 6.810 / 7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
    [case.scad]
2026-10-04 feat(case): the insert's carrier grows off the side wall (ADR-031)
    The two M3 that hold the lid stop biting inserts in pillars that stand off
    the back plate. The insert is now pressed into a gusset grown off the
    cavity's side wall -- the same family as the arcs that cradle the unit --
    and the O4 x 10 hole is bored straight into its flat top. No boss and no
    cone: a boss needs its far end closed against open air, and the ramp's own
    top is already the flat surface the print lays down last, normal to the
    screw.
    One profile in (x, y) extruded across z, mirrored for the second screw:
    face at x = +-14.00 (2.00 of material around the hole), the cradles' own
    0.84 ramp from y = 15.00 out to the wall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
    [case.scad]
2026-10-04 fix(case): the gland's tail lands its point on the back face (ADR-032)
    The gland moves 3.90 mm further back along +Y: gland_cy 40.44 -> 44.34, now written as
    case_d - gland_tail_reach, so the boss's tail's point lands exactly on the case's back
    face -- which is the bed. The boss's first layer is printed on the plate instead of
    3.90 mm above it: in z from 94 to 96.80, where the plate exists, the tail merges into it
    as a buttress, and above the case's top (96.80) the point is a first layer on the bed.
    ADR-030's limit was not the limit. It stopped where the boss's tail cleared the cavity's
    floor by 0.50, aiming to bring the teardrop's beginning as low in the print as the part
    allows -- but the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
    [case.scad]
2026-10-24 feat(case): the vent takes a screwed breather, the button's pocket is 25.00 (ADR-033)
    The vent is no longer a stick-on patch: it takes a bought M5x0.8 e-PTFE breather
    valve, and 4.20 mm is that thread's tapping drill, so the hole in the -X wall is the
    pilot the valve forms its thread in over 3.05 mm of ASA (3.8 turns). The bridge over
    it goes 4.0 -> 4.2 (rule 4 allows 10) and the patch's adhesive land is 2.90 either way.
    The button's cutout is now btn_sw + btn_clr = 22.00 + 0.10, and its outer land -- the
    gasket's seat and the flange's pocket -- drops from 29.00 to 25.00, which leaves a
    1.45 mm ring around the hole (rule 3's floor is 1.20) and a flat floor at 1.21 with
    0.52 of edge depth.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
2026-10-25 feat(case): the case takes a height knob, the rim becomes a 2 mm roll (ADR-034)
    - case_h 130.00, btn_cz 79.40, m3b_dz 9.40: three Customizer knobs, each with a physical floor that make fit
    guards. Everything above the unit rises with it, so the 7.25 mm of new space is under the unit, where the
    2x9 header and its connectors need it.
    - cradle A': 0.50 of clearance and a 1.20 lead-in (the unit was hard to seat).
    - the shell's convex edges are rolled by 2.00 mm as the OPENING of the two prisms -- erode by r, dilate by a
    ball. That is the only construction of the five tried that rounds the crease over the two domes as well.
    - the button's pocket keeps its 90 degree mouth; the round-over was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
2026-10-26 feat(case): the screw heads sink 1.40 below the crown, and the holes get a cap (ADR-035)
    - m3b_head_h 3.20 -> 4.40: the DIN 912 head sits 1.40 below the crown instead of 0.20. Floor at 5.86,
    1.61 of boss material under it (rule 3: 1.20); the knob's ceiling is 4.81.
    - the cap is a SLICE OF THE CROWN (part="cap", make cap): its top is cut by the case's own front cylinder,
    so it closes the hole with no step to sand and no spot-face to hide. Flat bottom, which is both what it
    prints on and what stops it -- it lands on the socket head's top face and seats flush instead of sinking.
    cap_h = m3b_head_h - 3.00, derived; Ø5.50 in the Ø5.70 bore, 0.40 lead-in.
    - fitcheck_cap is new and make f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
